spaldrich13/edge-co2-beacon/reports/Presentations/1-Aldrich_Update_Week6 .pdf

## Edge-Based Transportation Classifier for Real-Time CO₂ Estimation

Spencer Aldrich
ECE-499 - Winter 2026
Advisor: Michael Okwori

## Project Recap

- Goal: Classify transportation modes using on-device sensor data
- Target modes: train, subway, car, bus, walk
- Predicted mode feeds directly into CO2
estimation
- Constraints:
- Fully local data processing
- Battery-powered embedded system

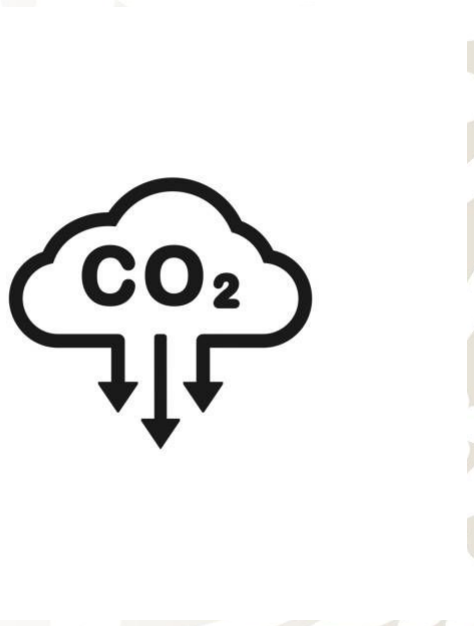
[picture p4: figure]

## Overall System Design

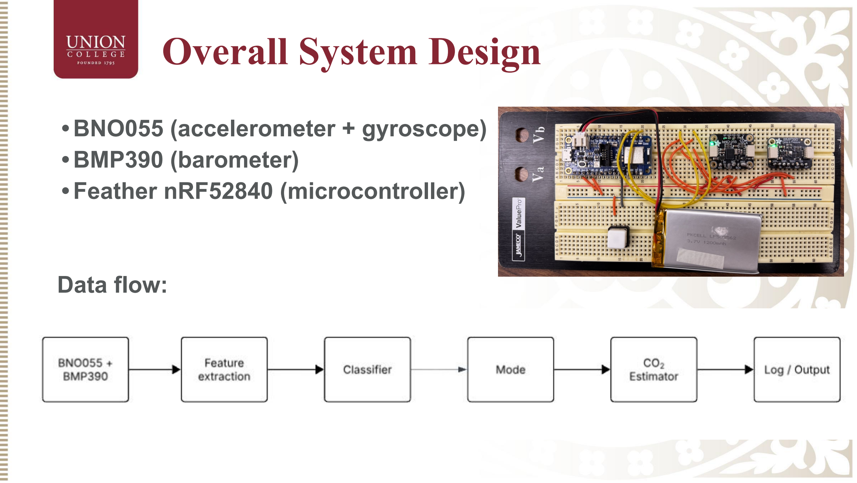
[picture p5: page 3]

- BNO055 (accelerometer + gyroscope)
- BMP390 (barometer)
- Feather nRF52840 (microcontroller)

Data flow:

•

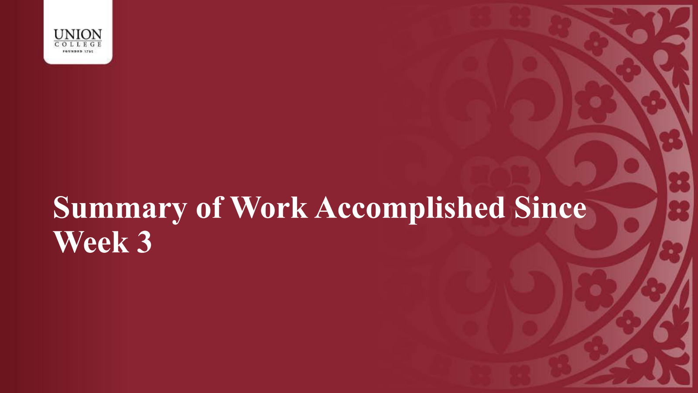
[picture p6: page 4]

## Summary of Work Accomplished Since Week 3

## Summary of Data Collection

•Self-collected dataset only (no SHL yet)
- Total Data Collected:
- Train: 81 minutes (~121,000 samples)
- Subway: 21 minutes (~31,500 samples)
- Car: 42 minutes (~63,000 samples)
- Bus: 58 minutes (~87,000 samples)
- Walk: 16 minutes (~24,000 samples)

## Data Preprocessing & Windowing

•Windowing: 5-second windows @ 25 hz (125 samples/window)
- Channels/windows: ax, ay, az, gx, gy, gz, pressure (7 total)
- Normalization: per-channel z-score using training-set mean/std

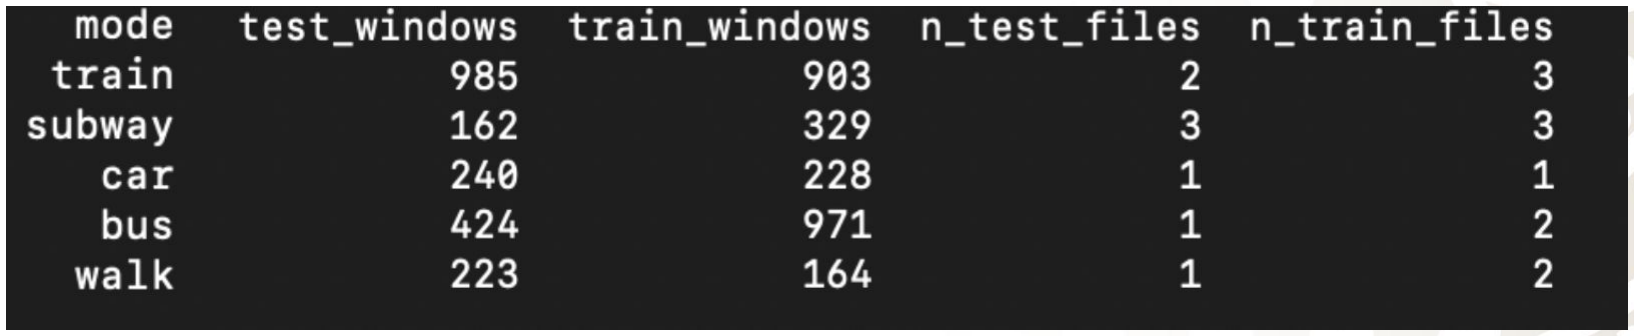
[picture p7: figure]

## Feature Variability Analysis

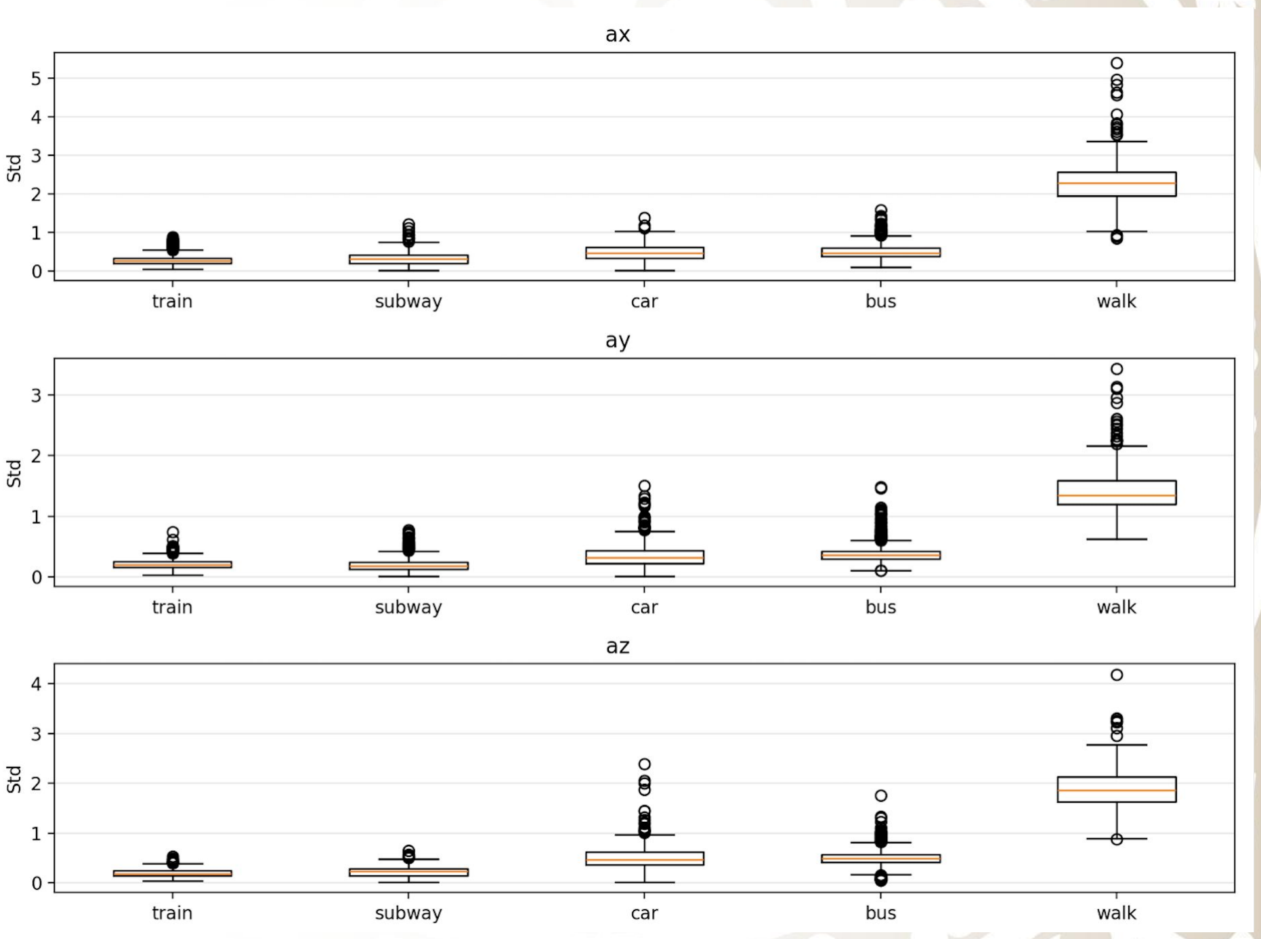
[picture p8: figure]

•Standard deviation computed per 5 second window.
- Captures short-term motion dynamics
- Higher std -> more
vibration/variation in that sensor during the window.

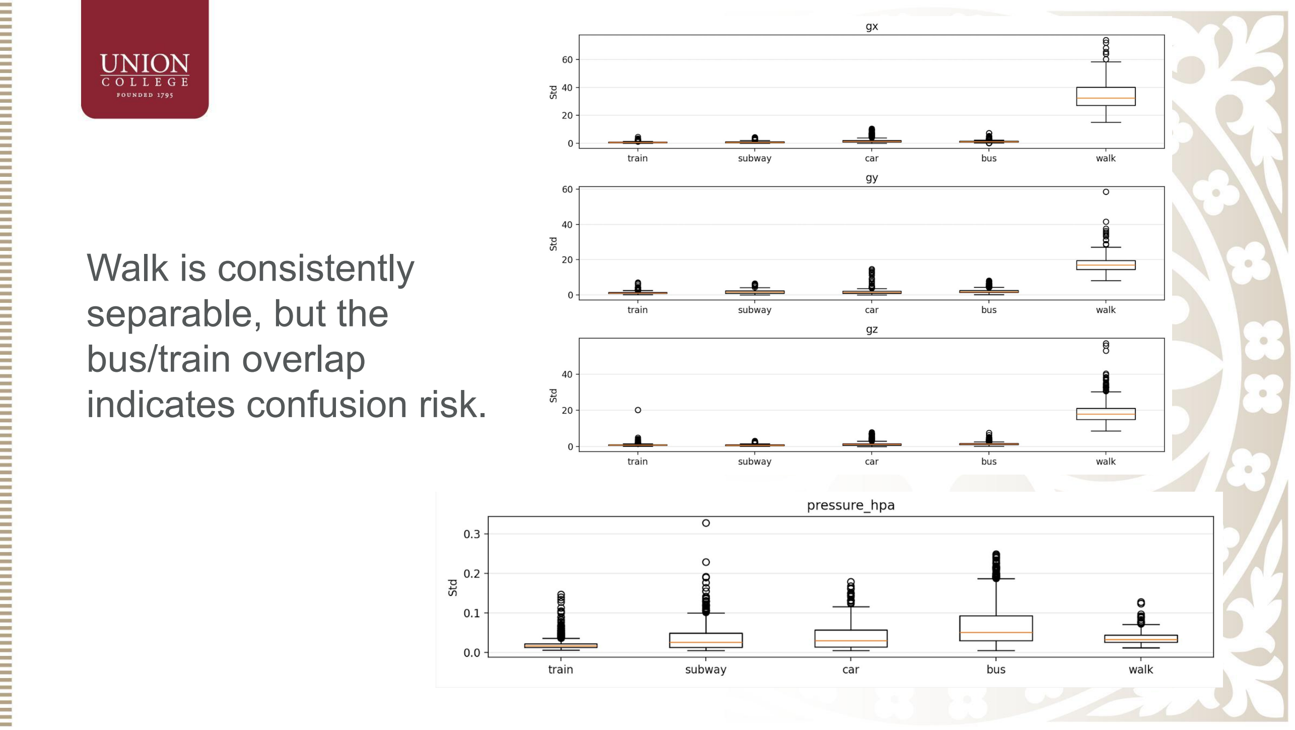
[picture p9: page 8]

Walk is consistently
separable, but the
bus/train overlap
indicates confusion risk.

## Baseline Model Selection

•Input: 5-second window @ 25 Hz (125 samples x 7 channels)
- Model: Convolutional Neural Network
- Learns motion patterns
automatically
- Strong baseline for IMU
time-series in the literature
- Baseline goal: establish a realistic generalization
benchmark before adding SHL pretraining or extra features.

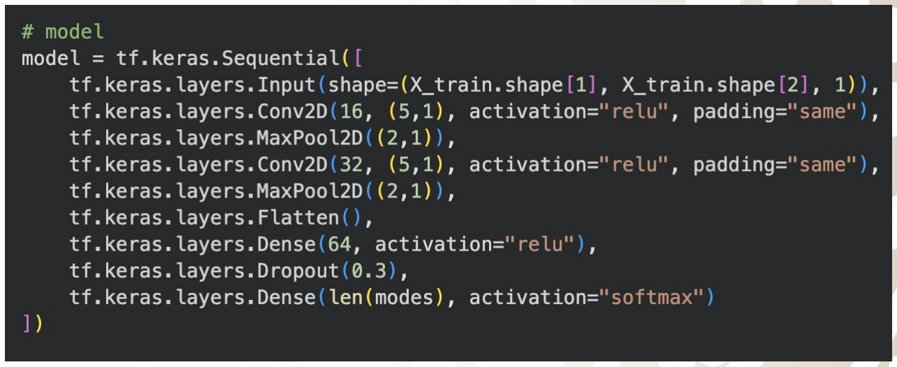
[picture p10: figure]

## Baseline Neural Network (Initial Result)

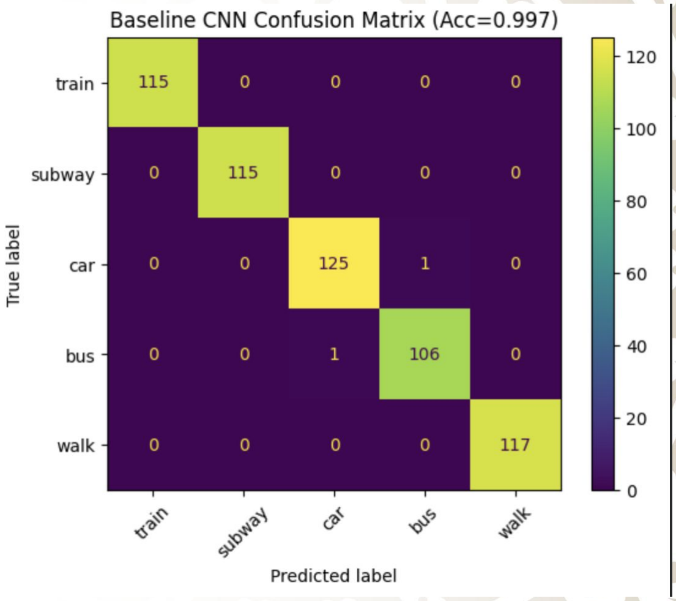
[picture p11: figure]

Initial accuracy: 99.7%
- Window-level random split caused leakage
- Not a valid estimate of
generalization

## Fixing Data Leakage

- Fixed split:
- Entire segments assigned to train or test
- No overlapping windows
across split
- Bus often misclassified with train, car also mixes with train/bus
- Baseline is limited to a small number of unique segments
(bus/car)

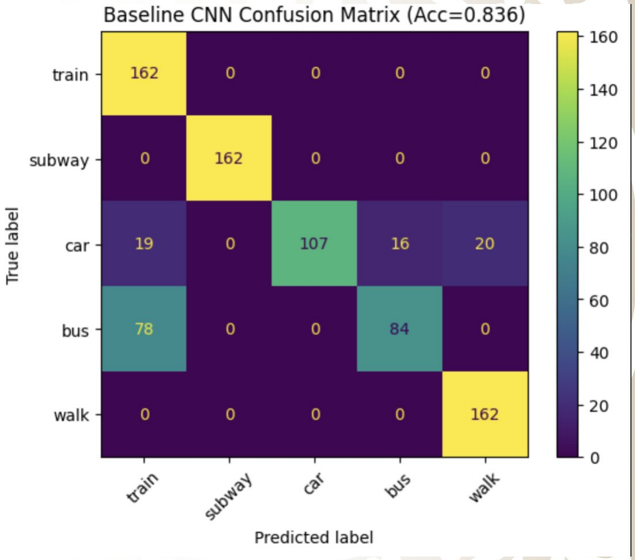
[picture p12: figure]

Classification Accuracy Target: ≥ 90%

## Plan for Remaining Project

Timeframe | Focus | Key Tasks | Outcome
Week 7 | Data and Model Generalization | ● SHL preprocessing and pretraining ● Fine-tune on self-collected data | Improved generalization on self-collected data
Week 8 | Model Refinement | ● Reduce bus/train confusion ● Validate on held-out self segments | Stable confusion matrix
Week 9 | CO2 Estimation | ● Apply emission factors per mode ● Compare predicted vs. true CO2 | CO2 error characterization
Weeks 10-11 | Deployment & Finalization | ● Model compression ● Latency + power evaluation | Final validated system
- Final Presentation
- Final Report

## Thank you

Questions?

aldrichs@union.edu

# Appendix - SHL Dataset (Sussex -Huawei Locomotion)

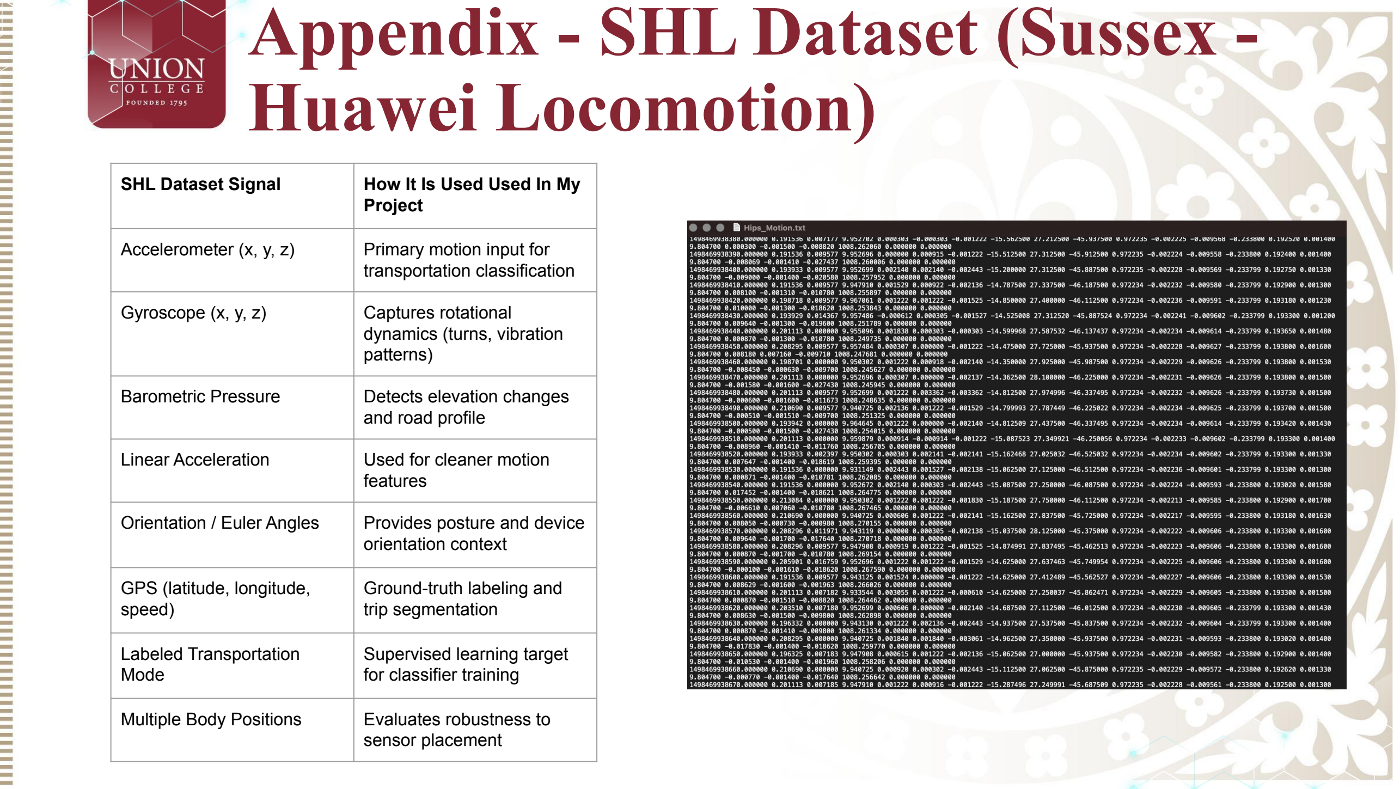
[picture p13: page 14]

SHL Dataset Signal | How It Is Used Used In My Project
Accelerometer (x, y, z) | Primary motion input for transportation classification
Gyroscope (x, y, z) | Captures rotational dynamics (turns, vibration patterns)
Barometric Pressure | Detects elevation changes and road profile
Linear Acceleration | Used for cleaner motion features
Orientation / Euler Angles | Provides posture and device orientation context
GPS (latitude, longitude, speed) | Ground-truth labeling and trip segmentation
Labeled Transportation Mode | Supervised learning target for classifier training
Multiple Body Positions | Evaluates robustness to sensor placement

# Appendix - CO2

# Estimation Model

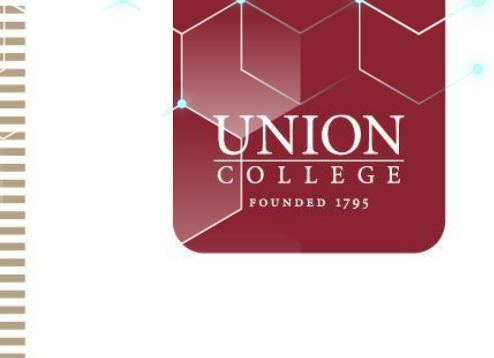
[picture p14: figure]

Objective: Estimate per-trip carbon emissions based on detected transportation mode, duration, and average speed, without continuous GPS tracking.

Calculation Framework:

CO2trip = EFmode * Dest

- EFmode = Emission Factor (grams of CO2

per km)

- Dest = Estimate Distance (km)
- Dest = vavg(mode) * tmode
Mode | Emission Factor (g CO₂ / km)
Car | 170 - 250 g CO₂ / km (per passenger)
Bus | 60 - 110 g CO₂ / km (per passenger)
Train | 25 - 45 g CO₂ / km (per passenger)
Subway | 44 - 65 g CO₂ / km (per passenger)
Walk | 0 g CO₂ / km (per passenger)

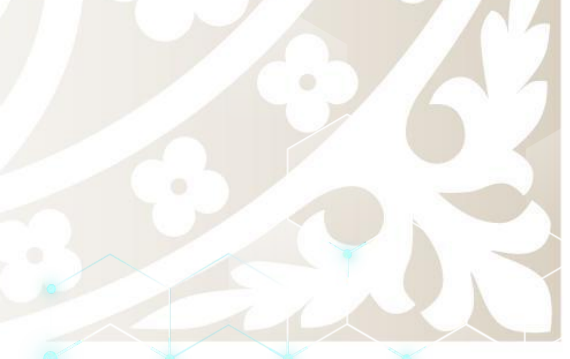
[picture p15: figure]

# Appendix - Acceleration Graphs

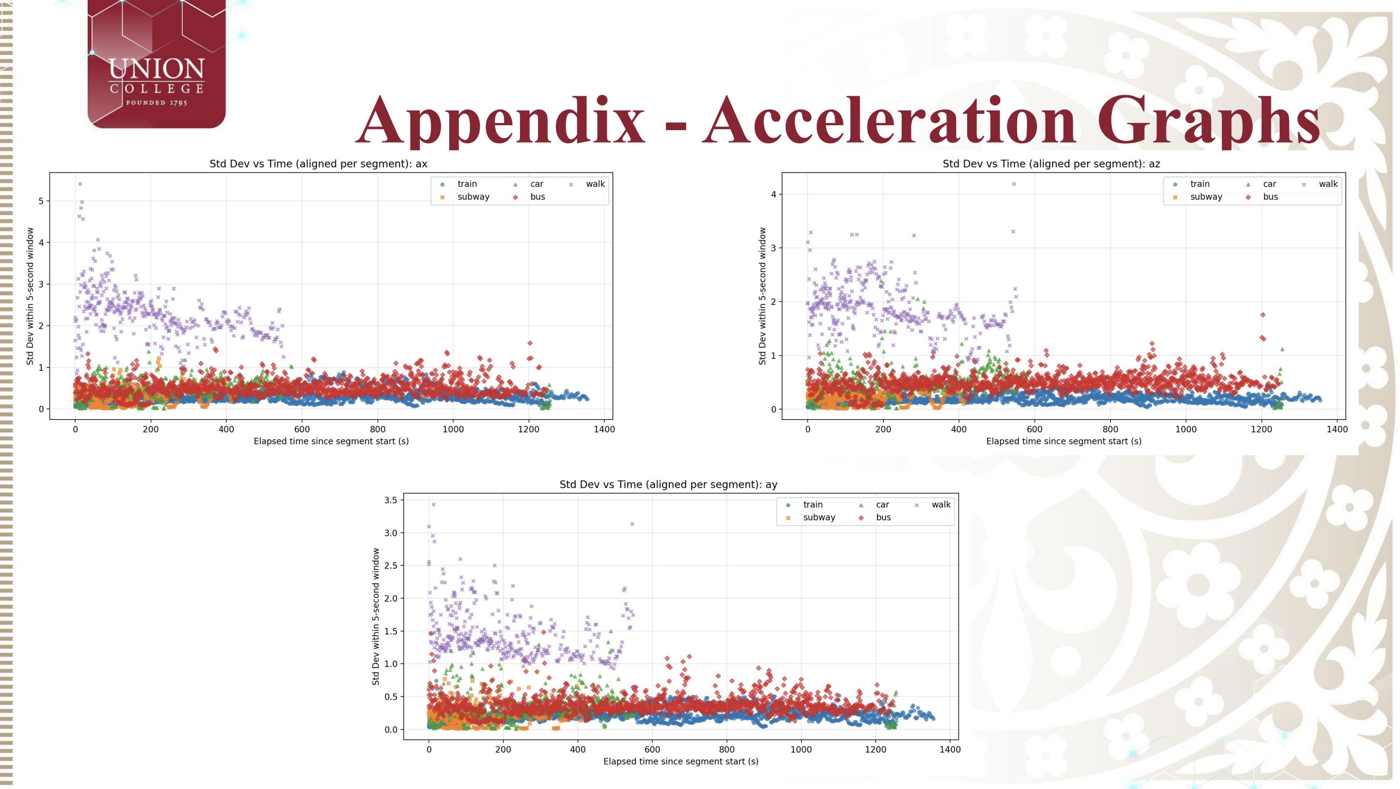
[picture p16: page 16]

# Appendix - Gyroscope Graphs

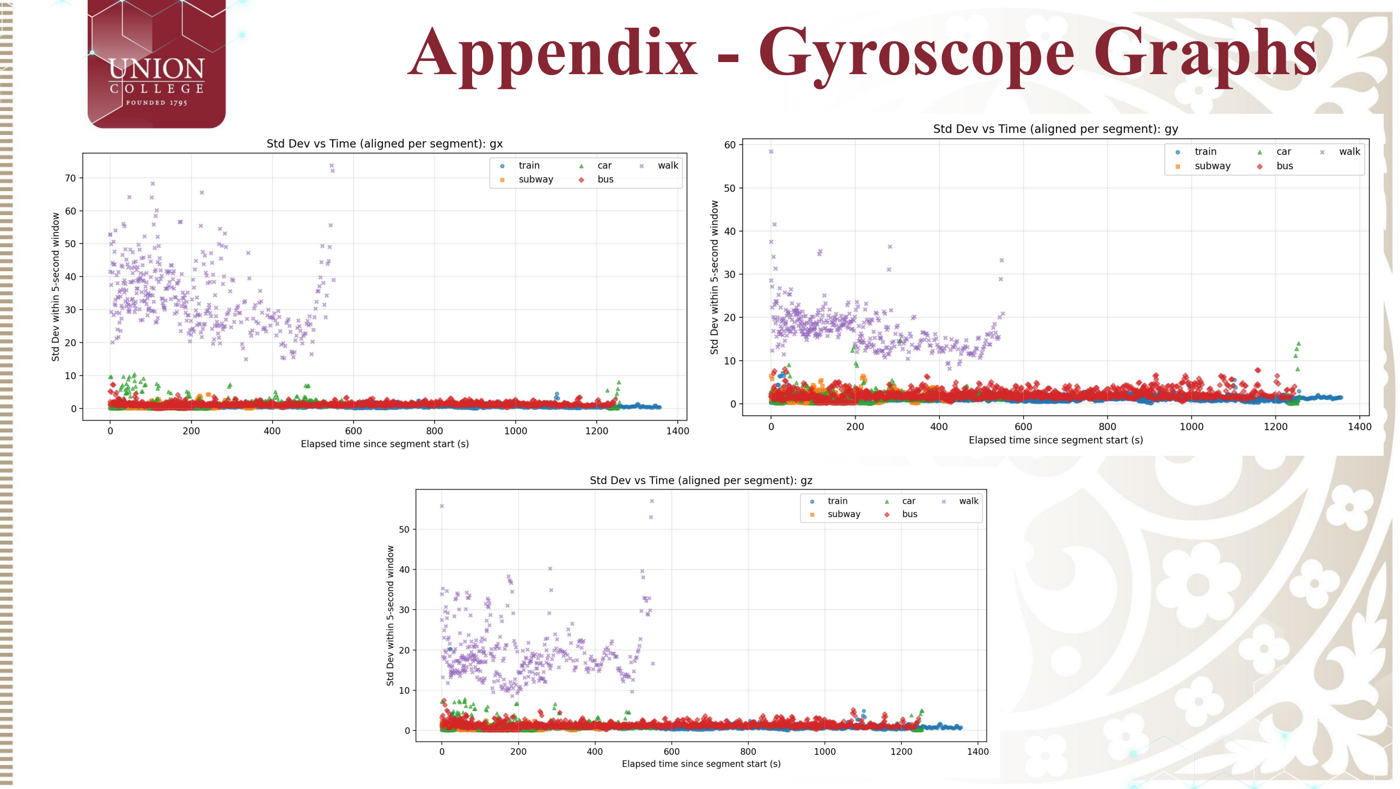
[picture p17: page 17]

# Appendix - Pressure Graph

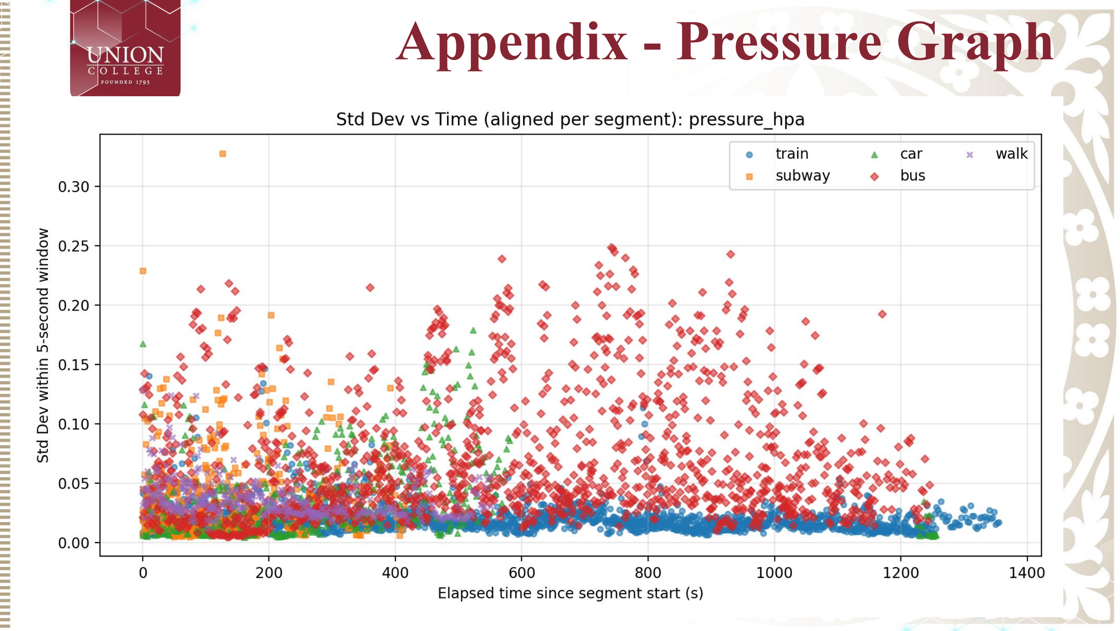
[picture p18: page 18]
