spaldrich13/edge-co2-beacon/logs/EE499 Weekly Activity Sheet_Week4.md

EE499 Weekly Activity Sheet

Name: Spencer Aldrich				Week: 4
Fill 1 before the weekly meeting and 2 after the weekly meeting
What did you work on and achieve this week?
Implemented a push button into the design for starting and stopping a trip. 
Began collecting data, including: 
6 subway segments totaling approximately 30 minutes of data
5 train segments totaling approximately 80 minutes of data

What are you working on/goal for next week?

Complete all remaining transportation mode data collection:
Car, walk, bus
Ensure that coverage across modes is balanced
Organize the dataset into a common training format
