spaldrich13/edge-co2-beacon/figures/ax_corr_std_vs_time.png

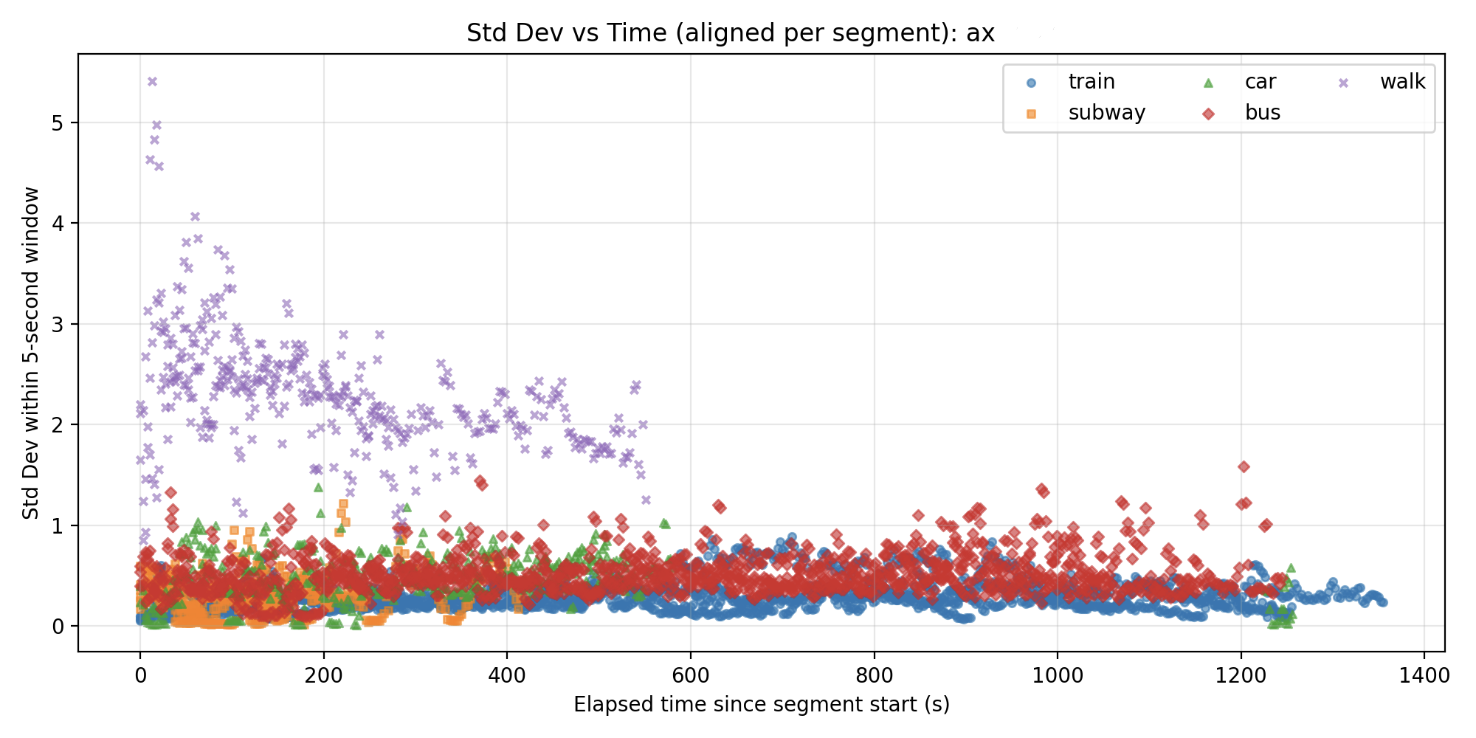
figures/ax_corr_std_vs_time.png
