spaldrich13/edge-co2-beacon/figures/ay_corr_std_vs_time.png

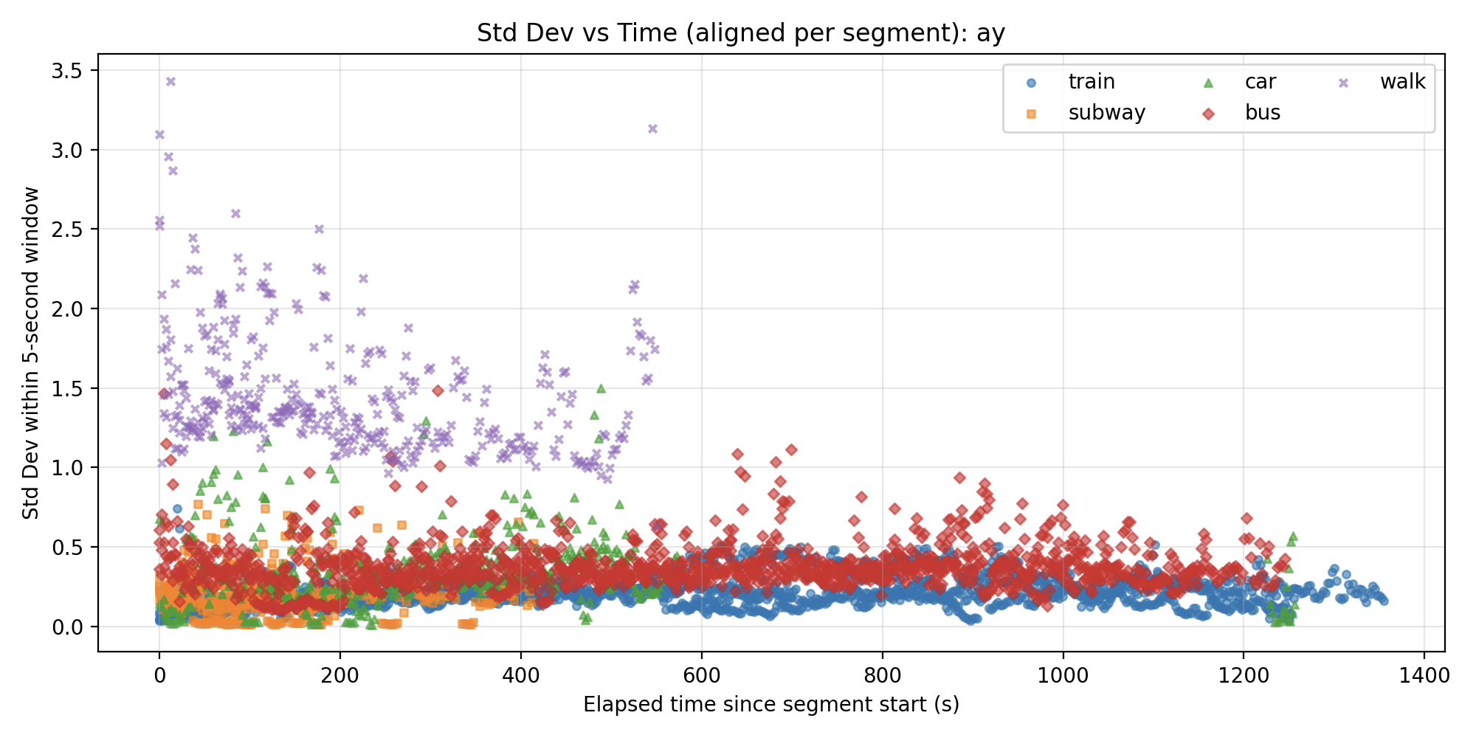
figures/ay_corr_std_vs_time.png
