spaldrich13/edge-co2-beacon/figures/az_corr_std_vs_time.png

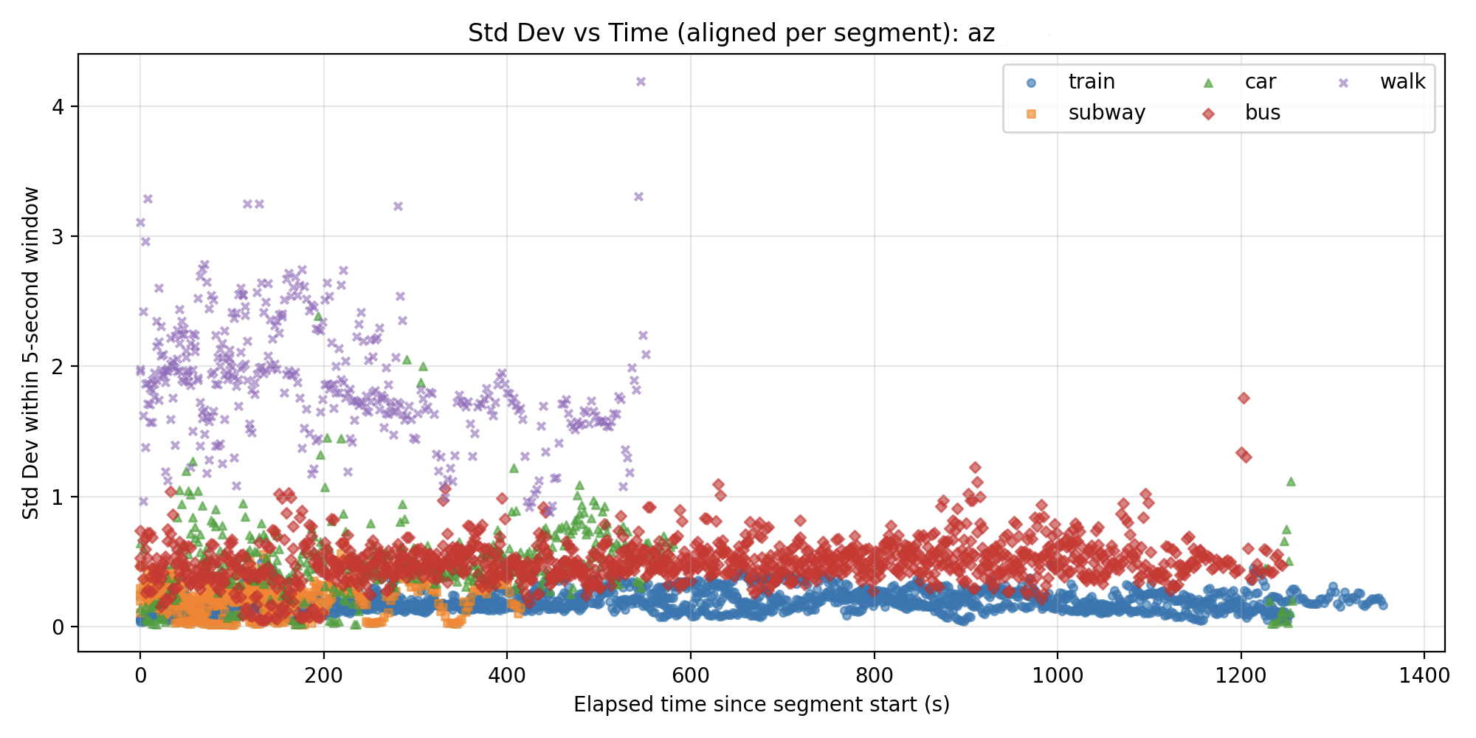
figures/az_corr_std_vs_time.png
