spaldrich13/edge-co2-beacon/figures/confusion matrices/Baseline Confusion Matrix 2:8.png

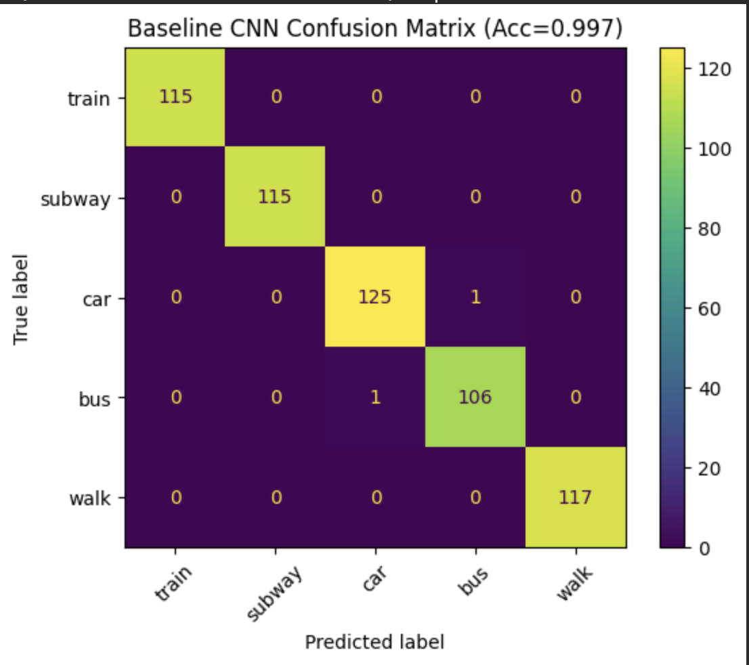
figures/confusion matrices/Baseline Confusion Matrix 2:8.png
