spaldrich13/edge-co2-beacon/figures/figures_boxplots/all_features_std_boxplots.png

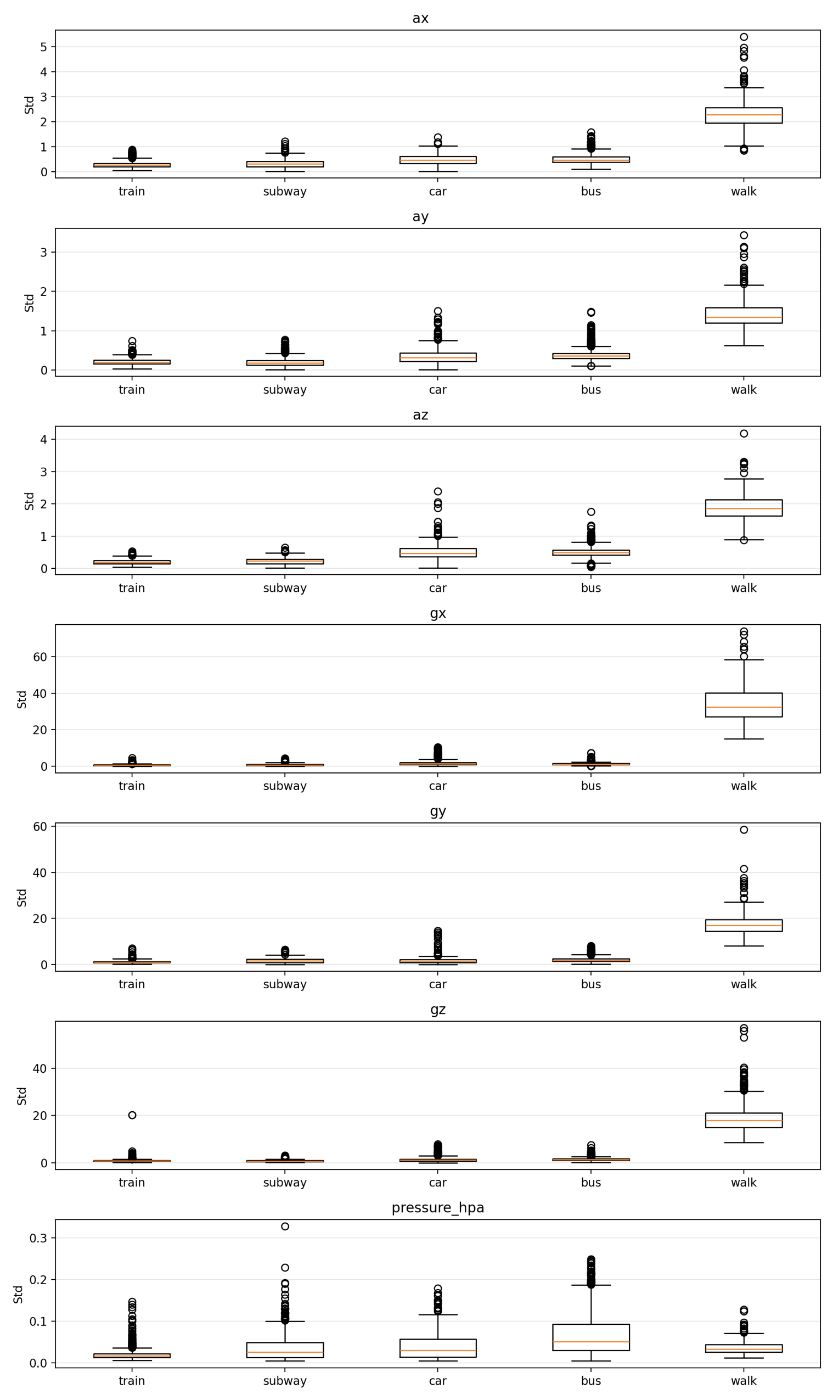
figures/figures_boxplots/all_features_std_boxplots.png
