spaldrich13/edge-co2-beacon/figures/figures_boxplots/az_corr_std_boxplot.png

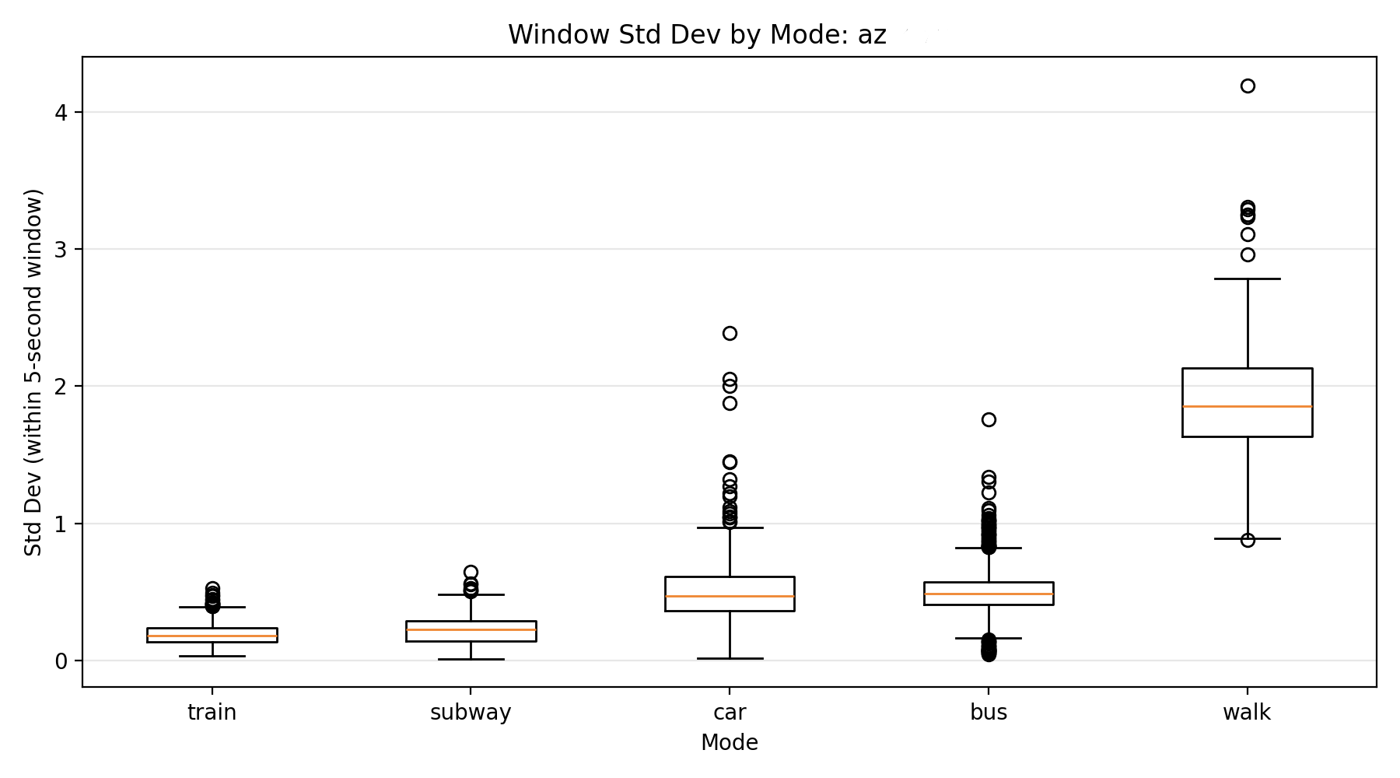
figures/figures_boxplots/az_corr_std_boxplot.png
