spaldrich13/edge-co2-beacon/figures/figures_boxplots/gz_std_boxplot.png

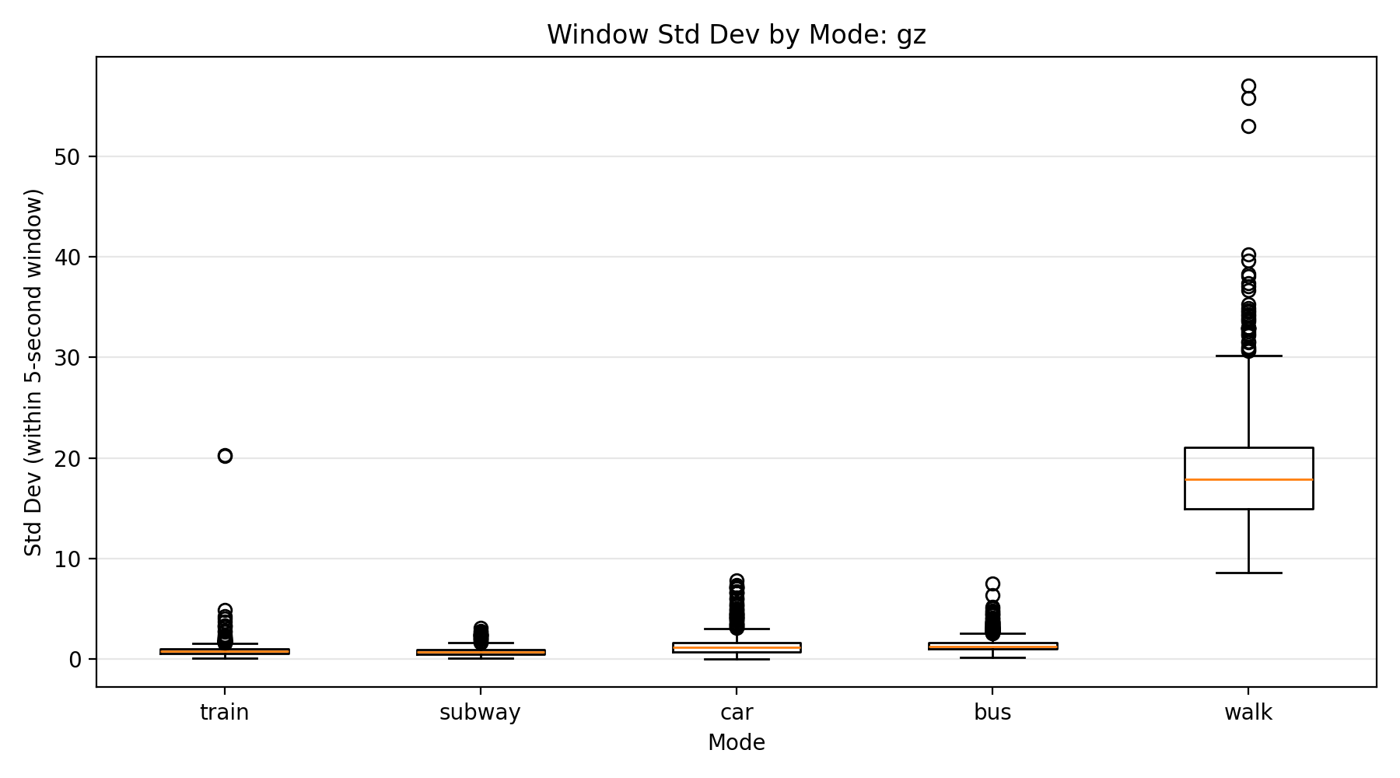
figures/figures_boxplots/gz_std_boxplot.png
