spaldrich13/edge-co2-beacon/figures/figures_boxplots/pressure_hpa_std_boxplot.png

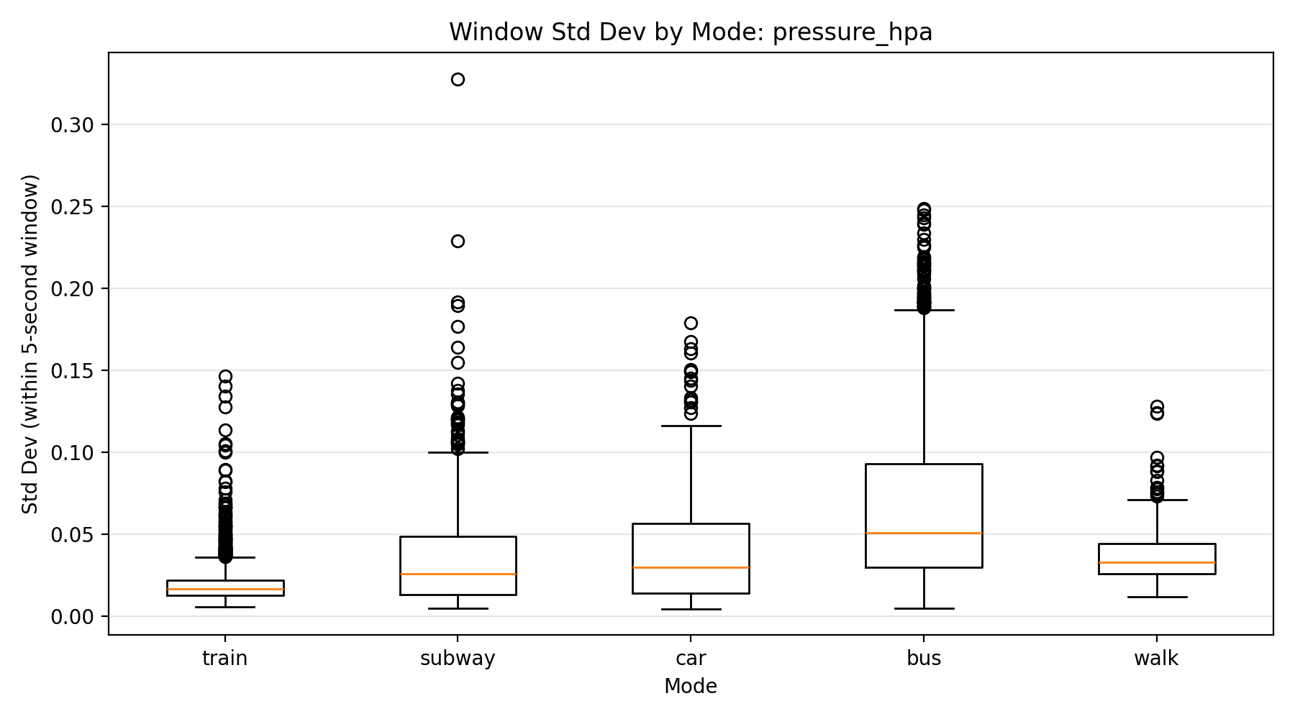
figures/figures_boxplots/pressure_hpa_std_boxplot.png
