spaldrich13/edge-co2-beacon/figures/figures_raw_signals/bus_ay_corr_raw.png

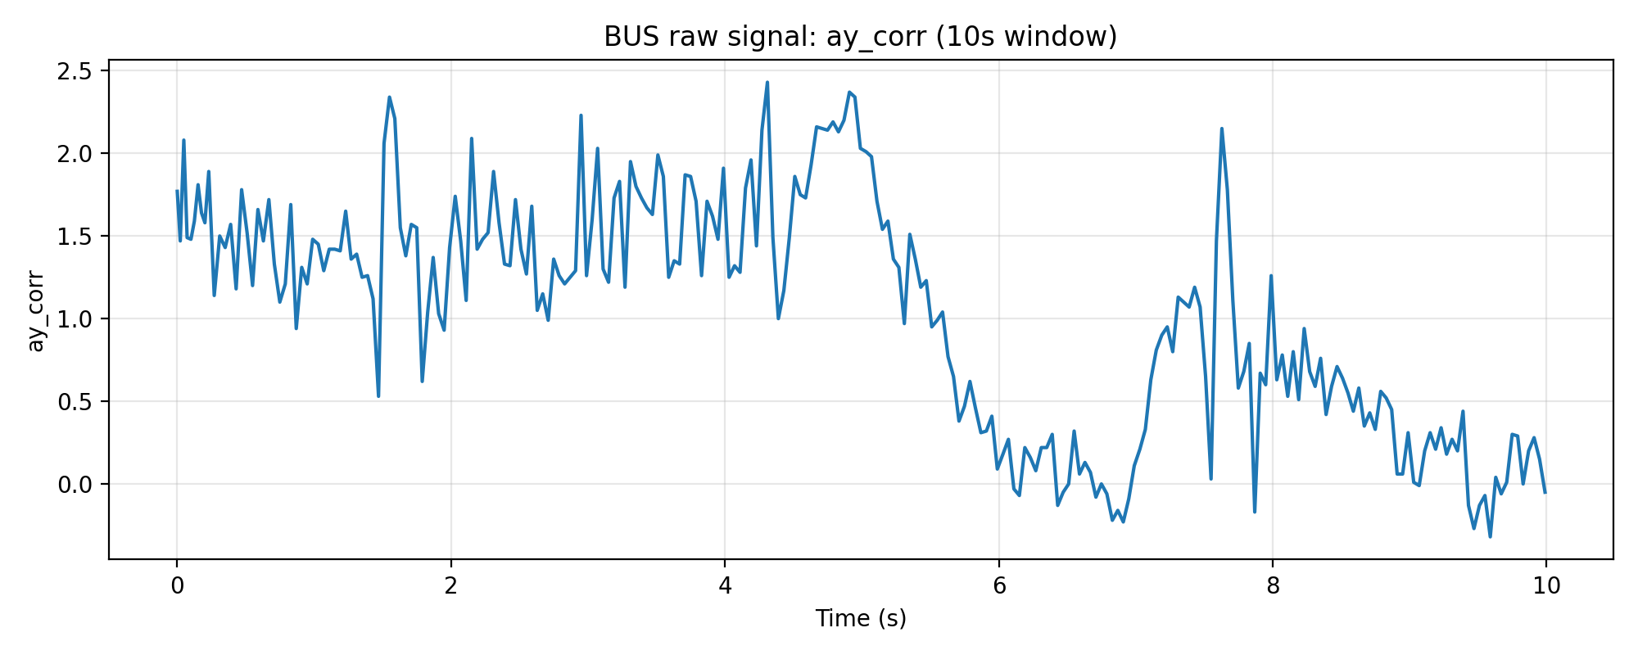
figures/figures_raw_signals/bus_ay_corr_raw.png
