spaldrich13/edge-co2-beacon/figures/figures_raw_signals/bus_pressure_hpa_raw.png

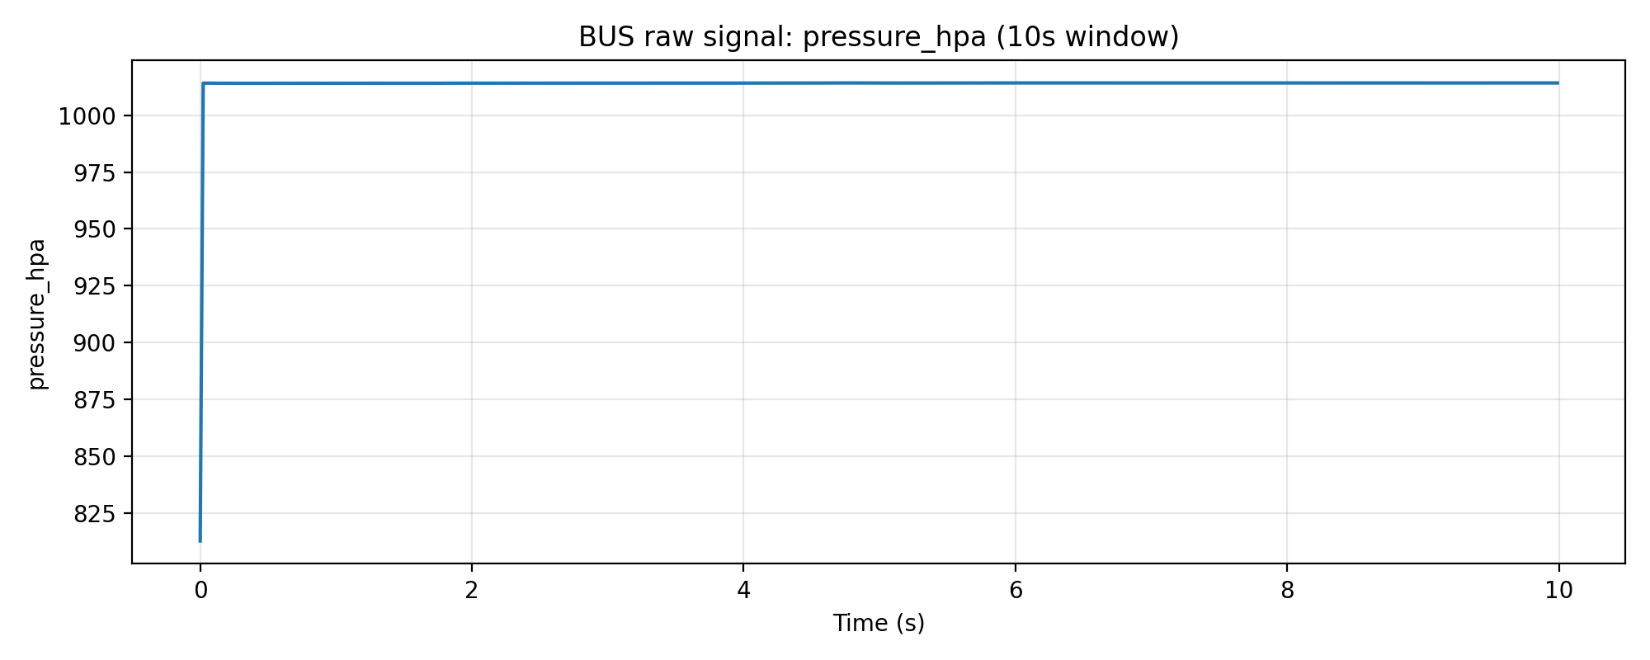
figures/figures_raw_signals/bus_pressure_hpa_raw.png
