spaldrich13/edge-co2-beacon/figures/figures_raw_signals/car_az_corr_raw.png

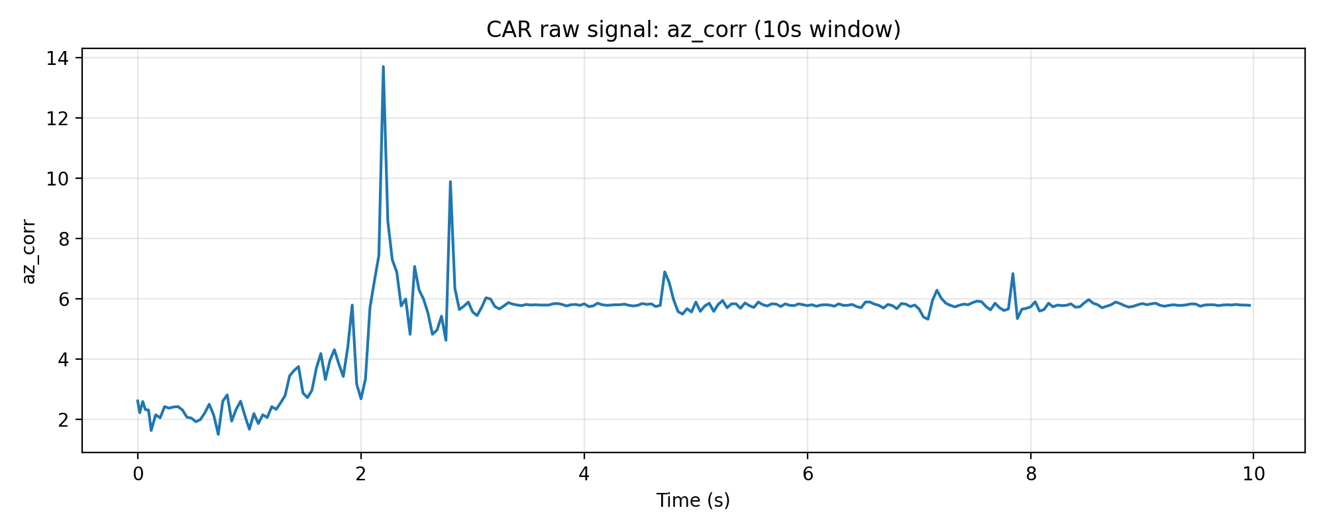
figures/figures_raw_signals/car_az_corr_raw.png
