spaldrich13/edge-co2-beacon/figures/figures_raw_signals/walk_gx_raw.png

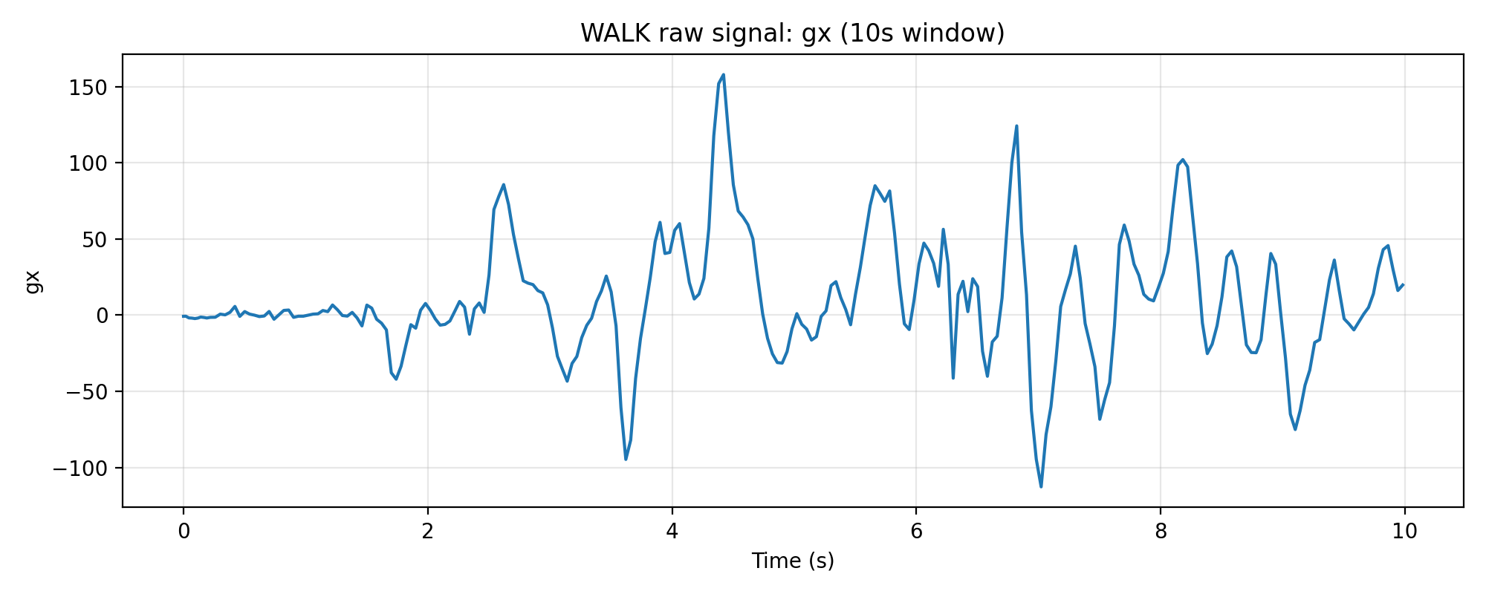
figures/figures_raw_signals/walk_gx_raw.png
