spaldrich13/edge-co2-beacon/figures/figures_raw_signals/walk_gz_raw.png

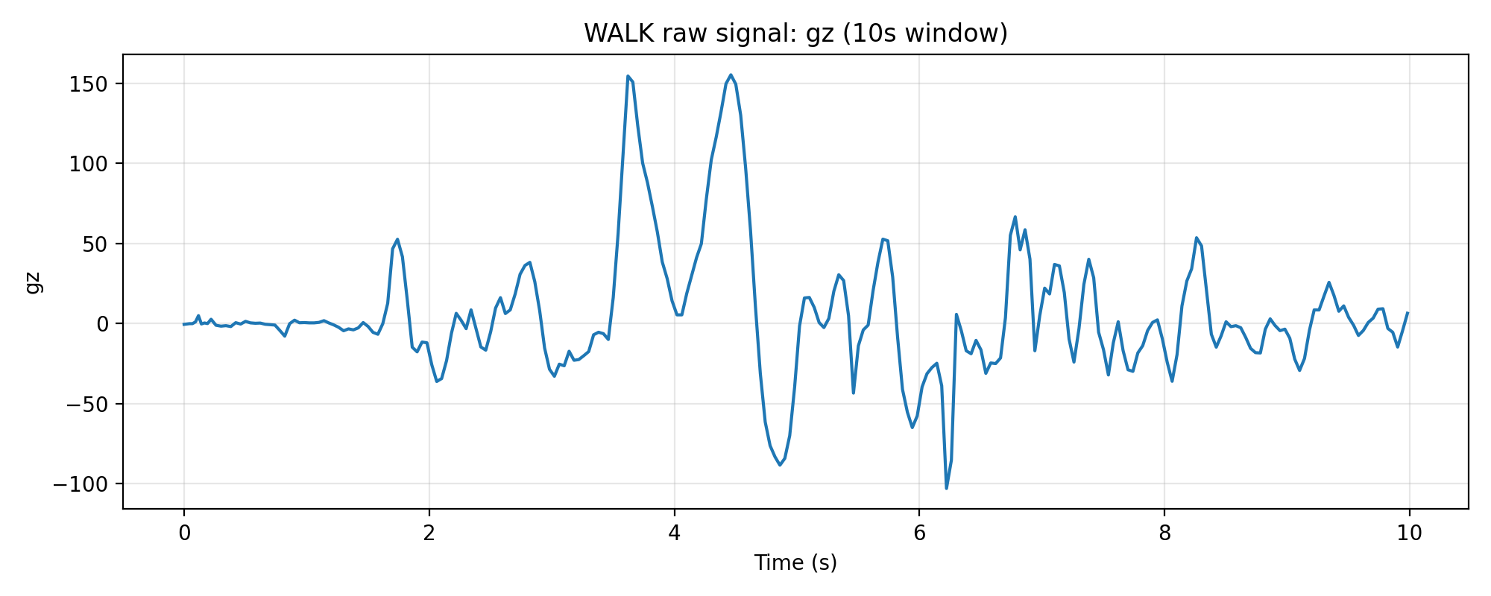
figures/figures_raw_signals/walk_gz_raw.png
