spaldrich13/edge-co2-beacon/figures/gx_std_vs_time.png

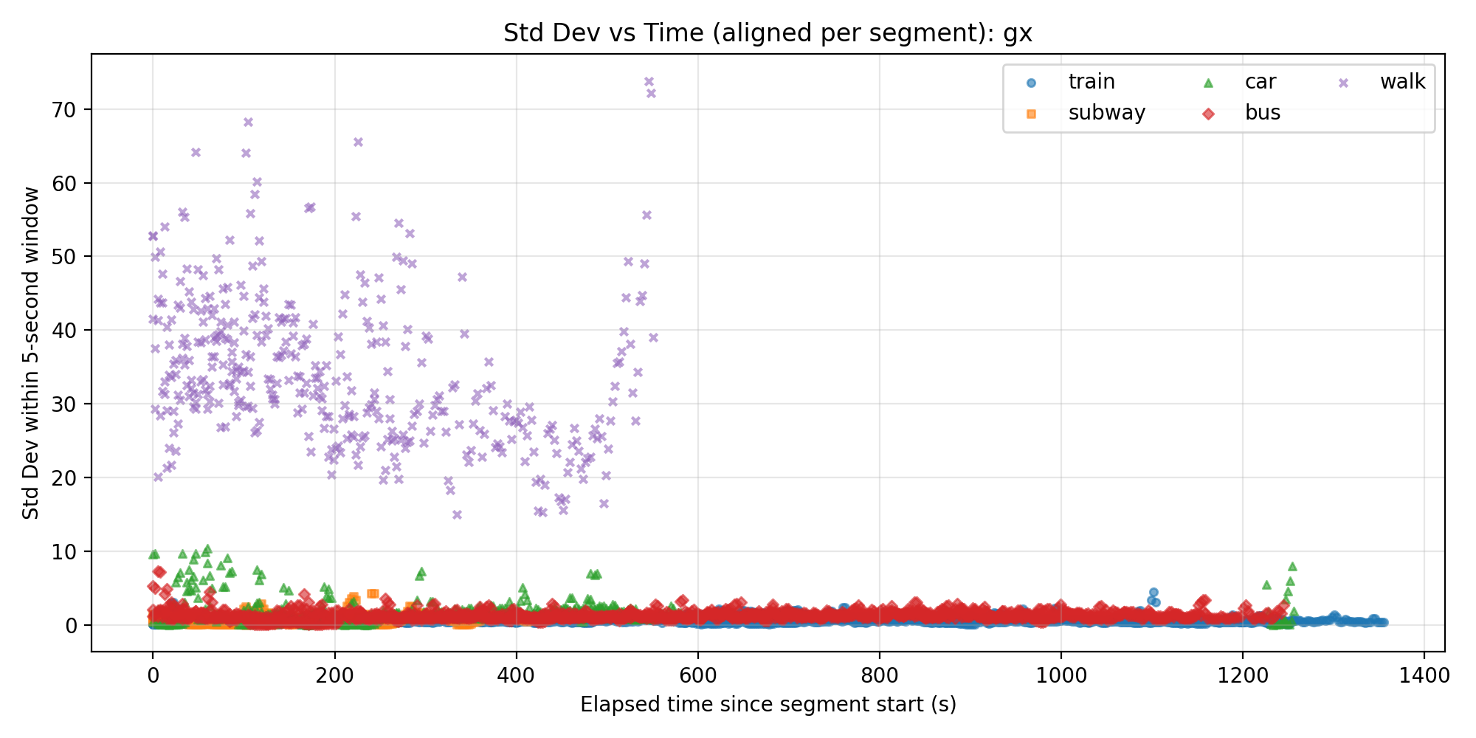
figures/gx_std_vs_time.png
