spaldrich13/edge-co2-beacon/figures/gy_std_vs_time.png

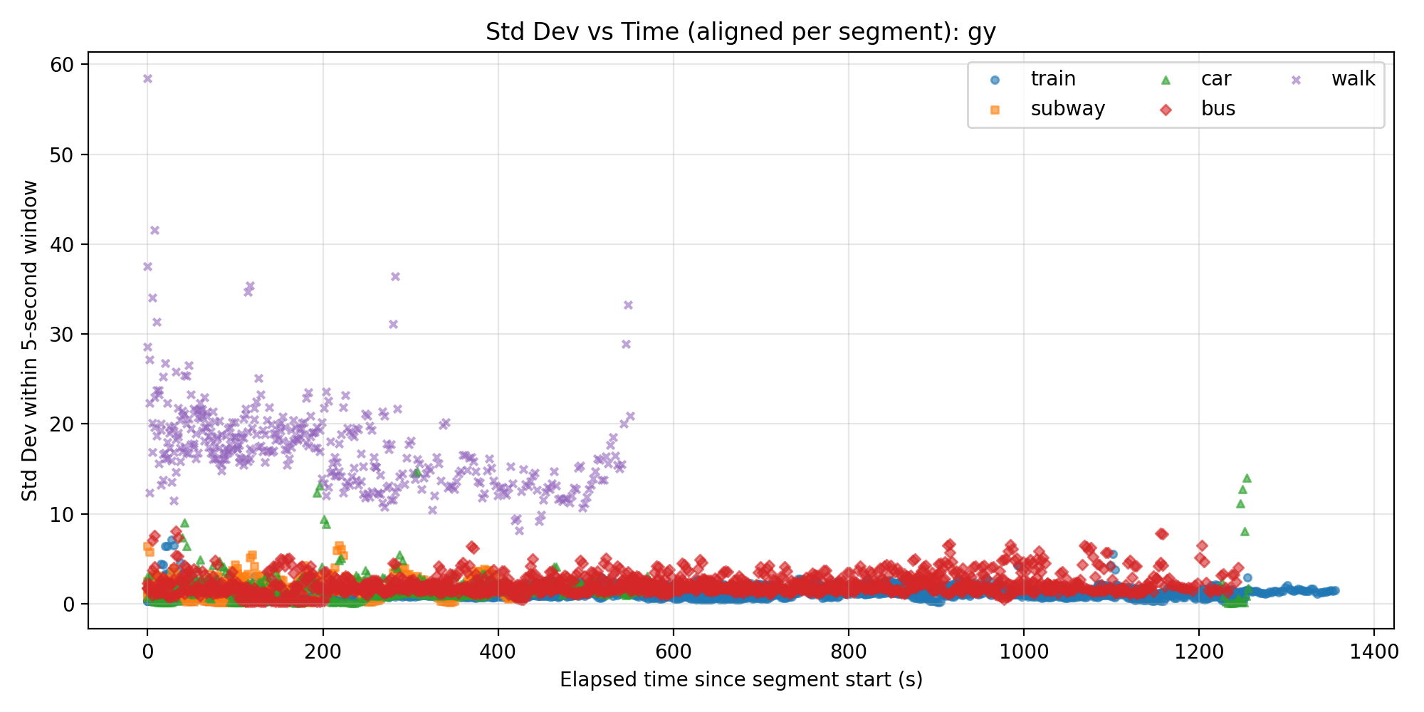
figures/gy_std_vs_time.png
