spaldrich13/edge-co2-beacon/figures/gyro_std_boxplots.png

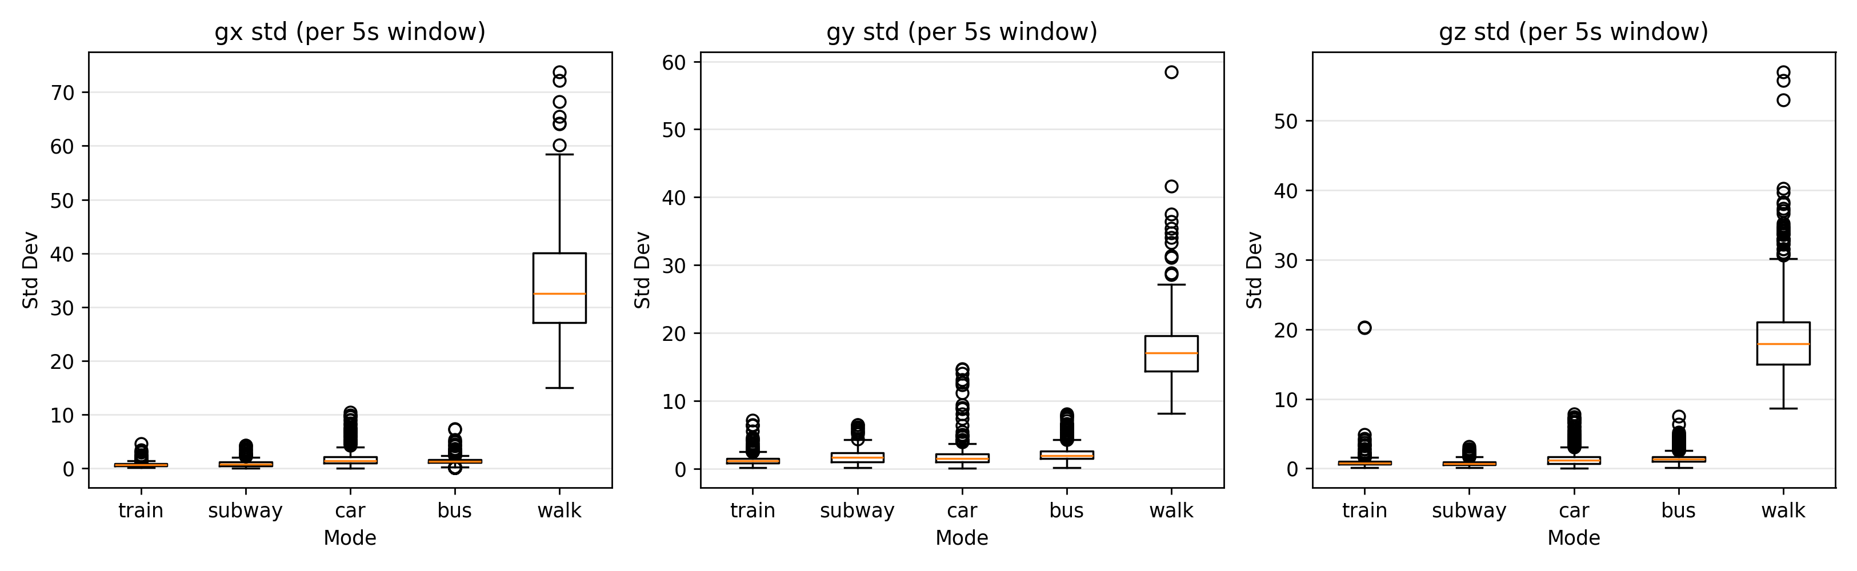
figures/gyro_std_boxplots.png
