spaldrich13/edge-co2-beacon/figures/gyro_std_mean_boxplot.png

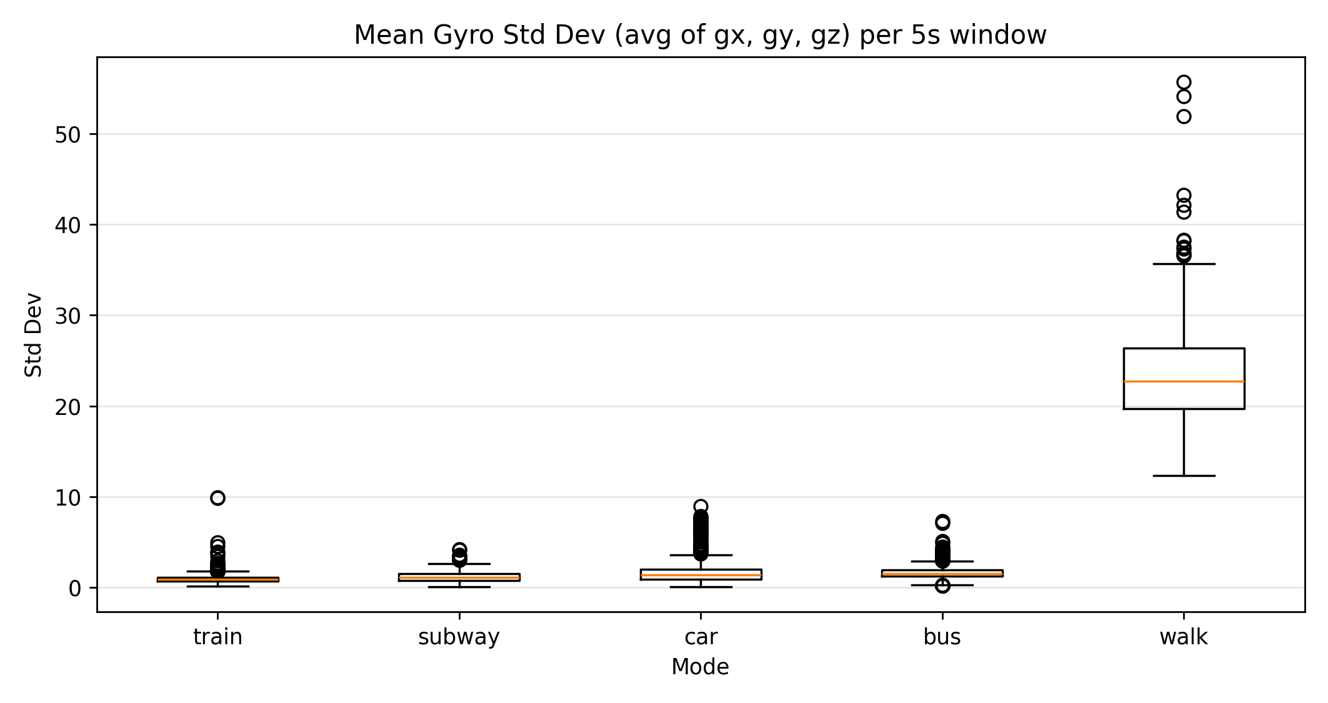
figures/gyro_std_mean_boxplot.png
