spaldrich13/edge-co2-beacon/figures/gz_std_vs_time.png

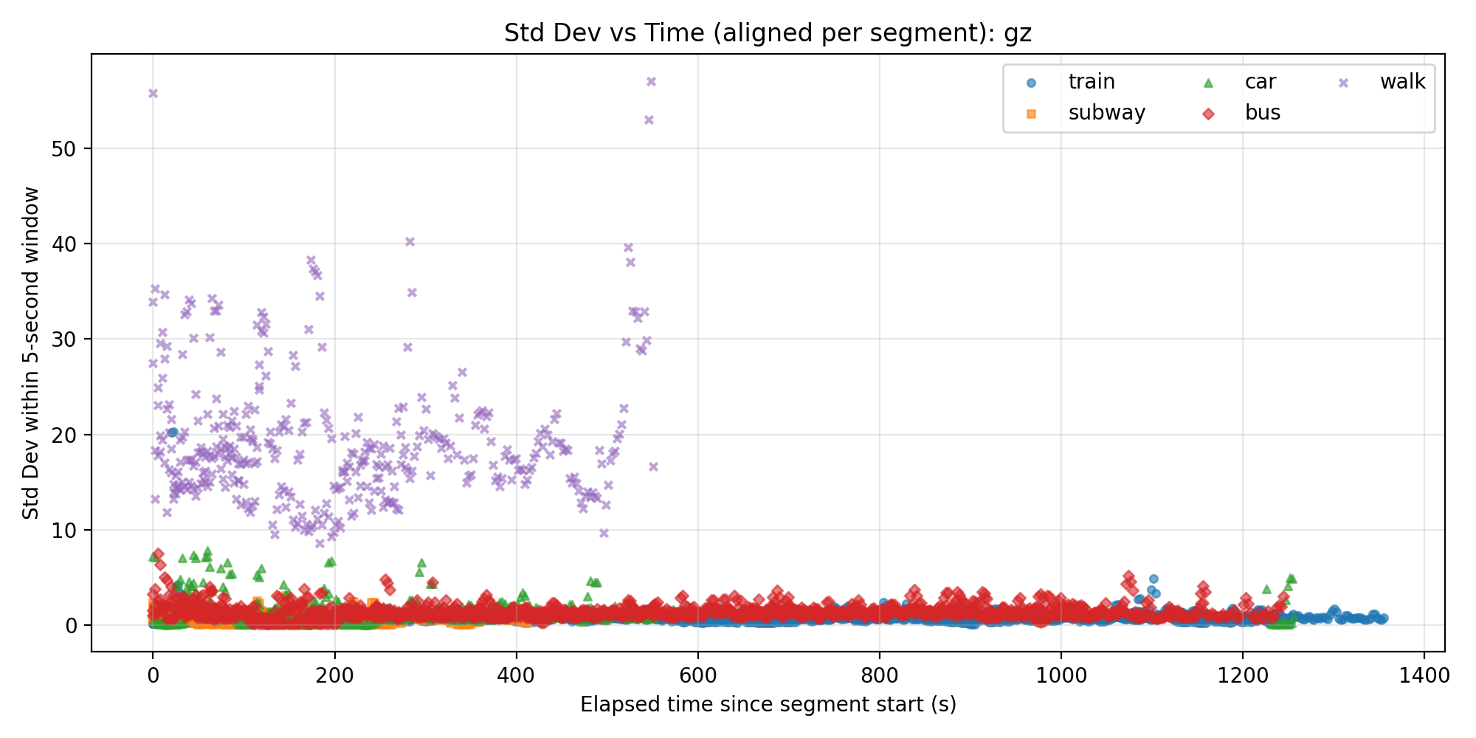
figures/gz_std_vs_time.png
