spaldrich13/edge-co2-beacon/figures/pressure_hpa_std_vs_time.png

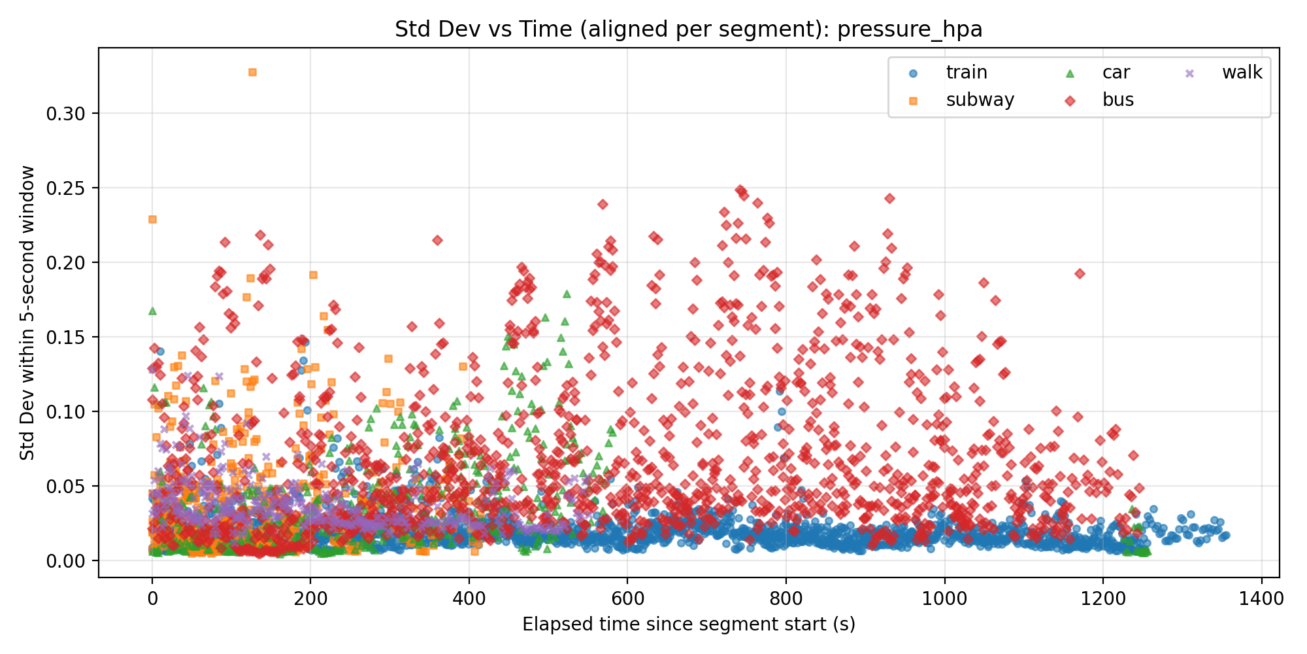
figures/pressure_hpa_std_vs_time.png
