spaldrich13/edge-co2-beacon/figures/std_vs_time_all_features.png

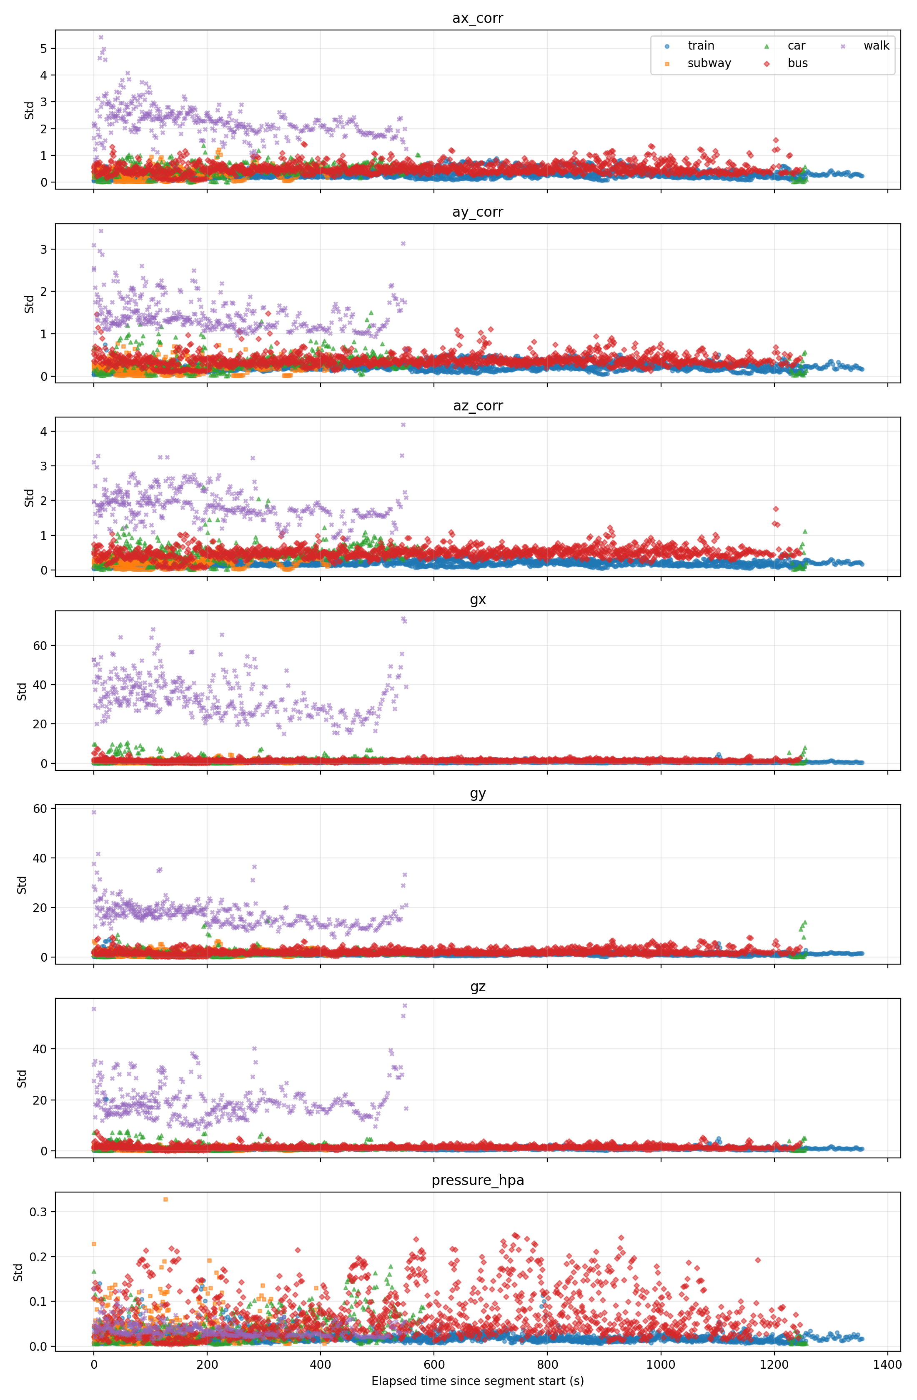
figures/std_vs_time_all_features.png
