spaldrich13/edge-co2-beacon/figures/Updated Prototype .png

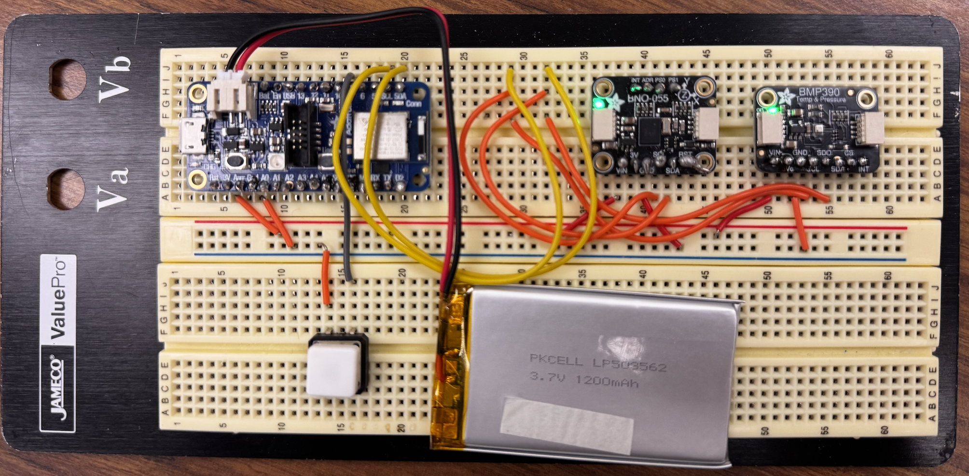
figures/Updated Prototype .png
