spaldrich13/edge-co2-beacon/notebooks/figs_fft/fft_ax_corr.png

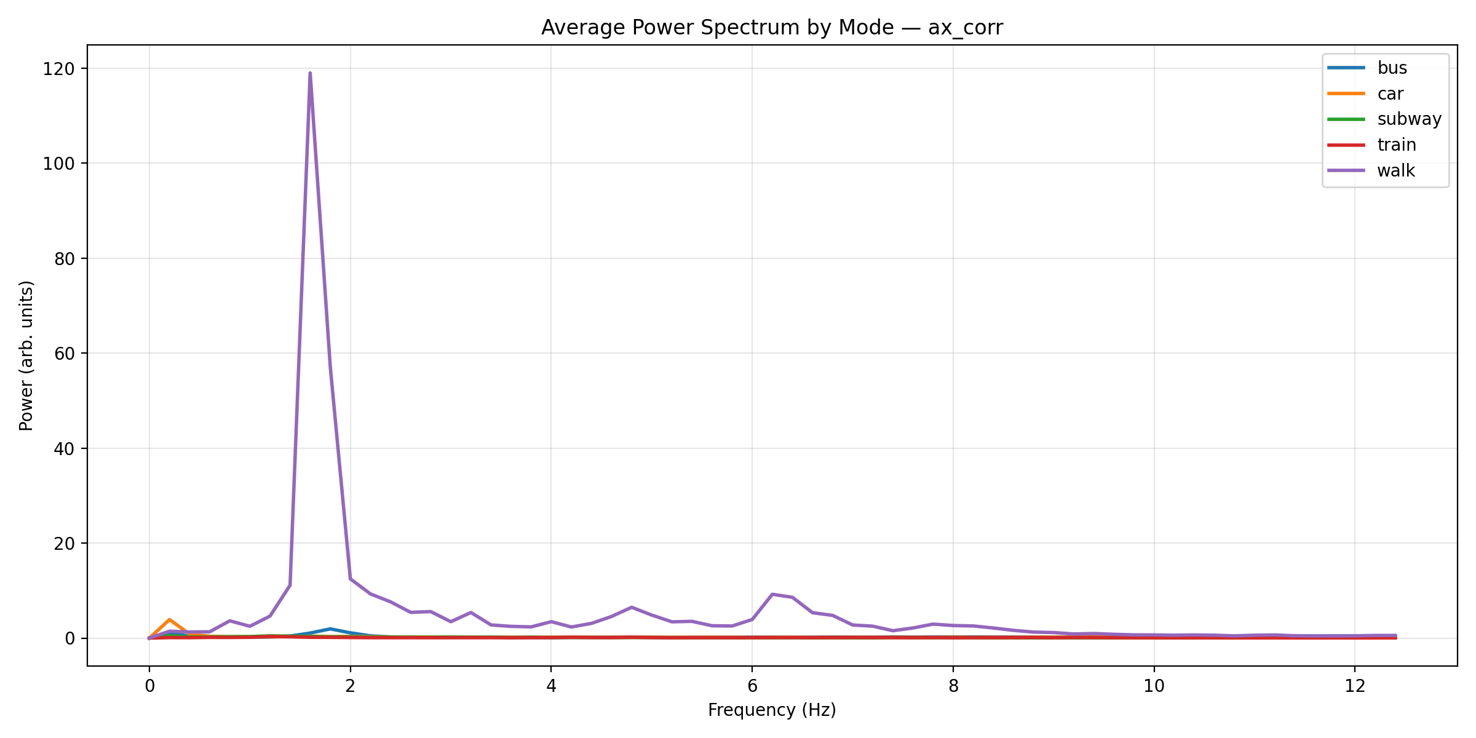
notebooks/figs_fft/fft_ax_corr.png
