spaldrich13/edge-co2-beacon/notebooks/figs_fft/fft_ay_corr.png

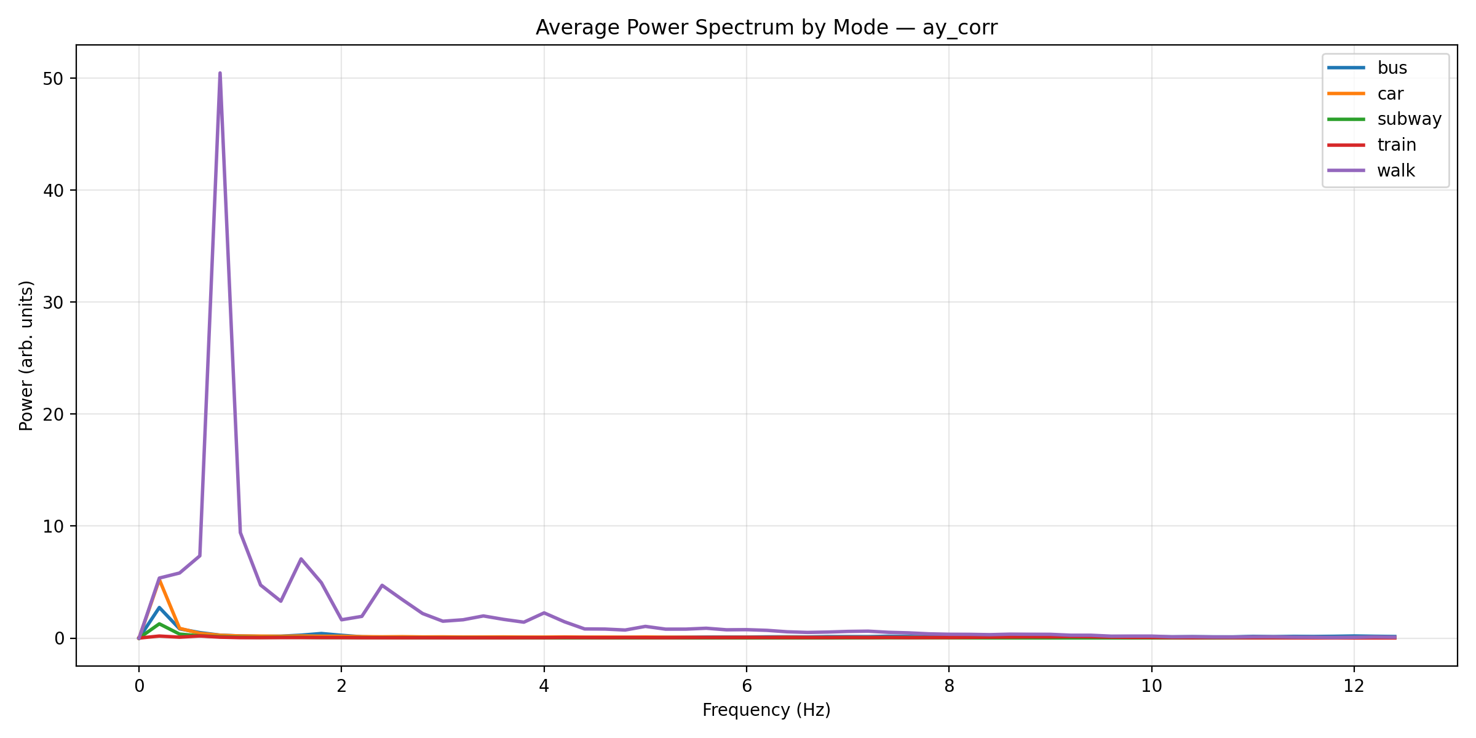
notebooks/figs_fft/fft_ay_corr.png
