spaldrich13/edge-co2-beacon/notebooks/figs_fft/fft_gx.png

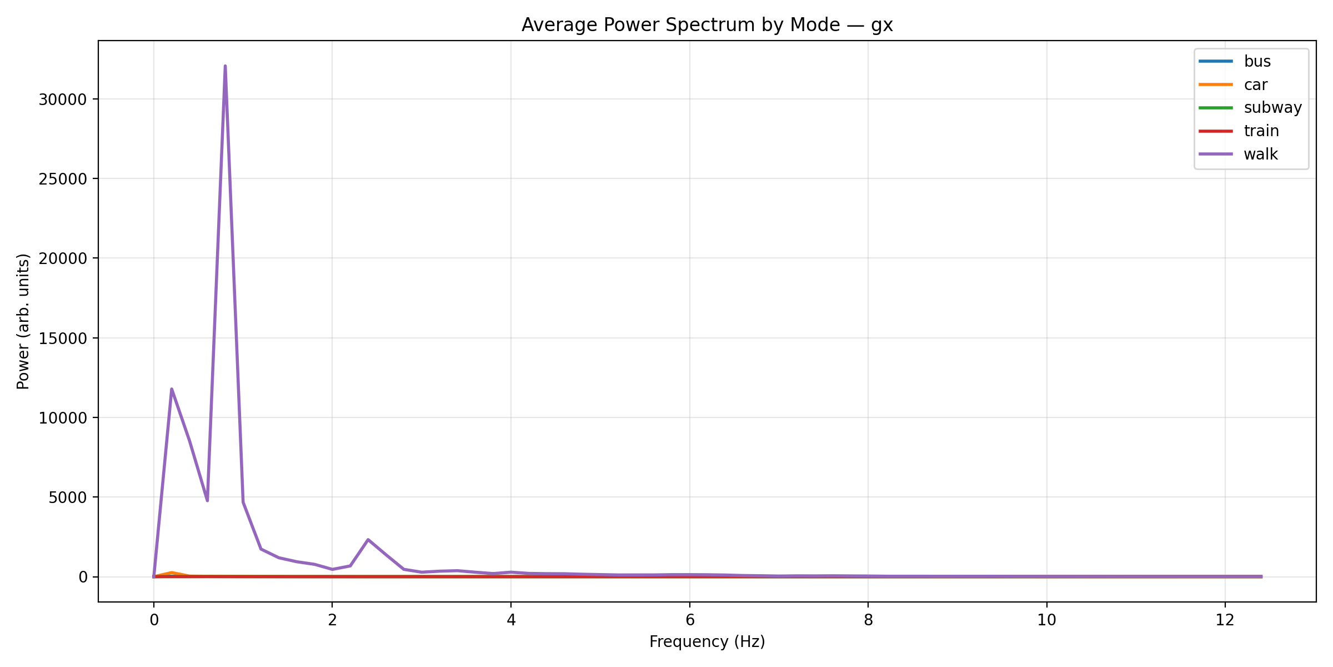
notebooks/figs_fft/fft_gx.png
