spaldrich13/edge-co2-beacon/notebooks/figs_fft/fft_pressure_hpa.png

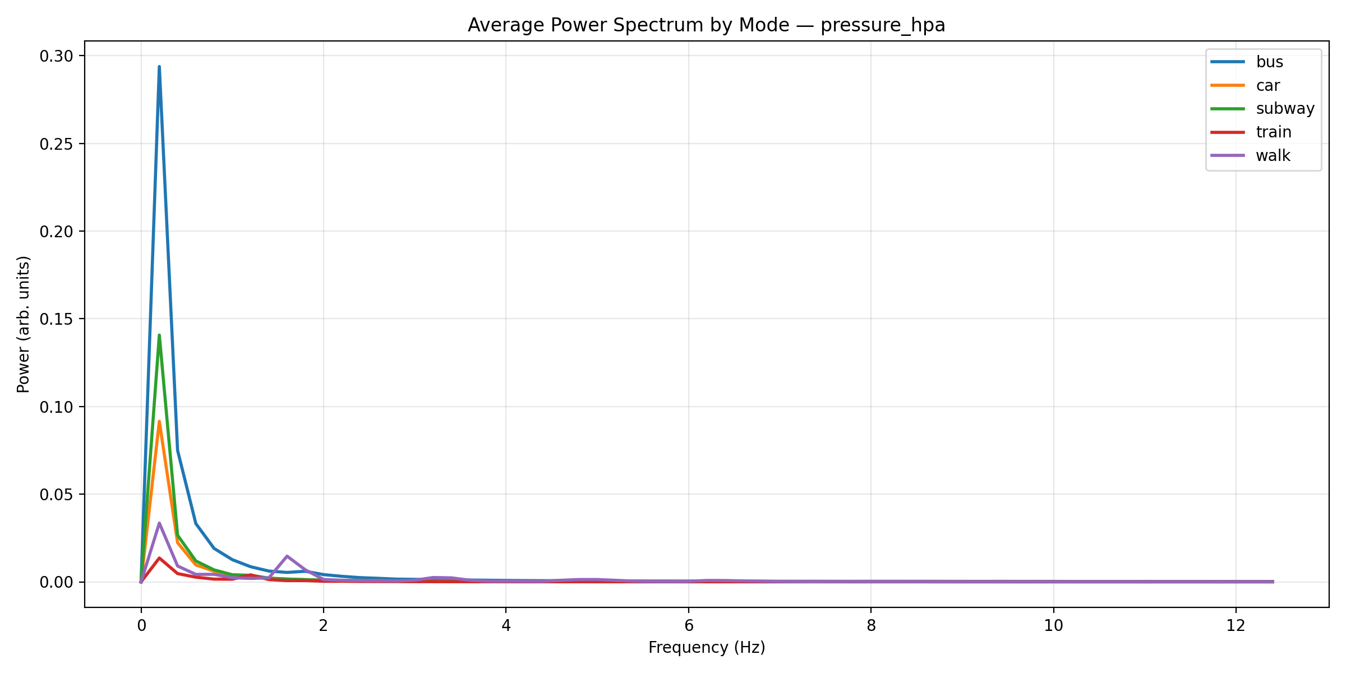
notebooks/figs_fft/fft_pressure_hpa.png
