spaldrich13/edge-co2-beacon/notebooks/figs_pca/pca_2d_projection.png

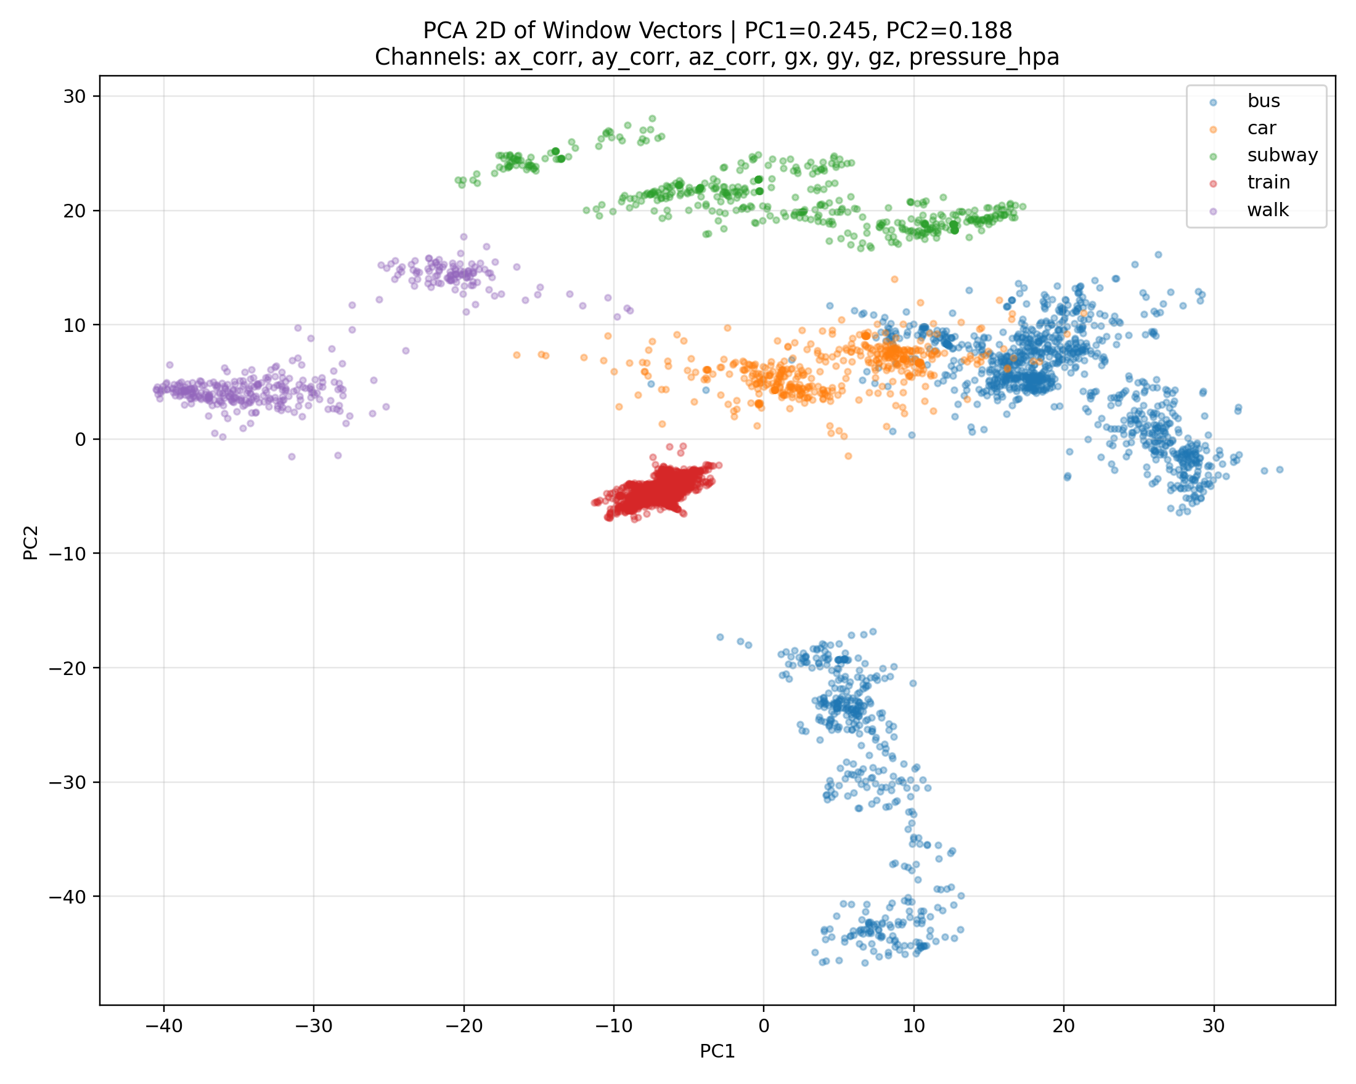
notebooks/figs_pca/pca_2d_projection.png
