spaldrich13/edge-co2-beacon/notebooks/plots_waveforms/overlay_bus_gx.png

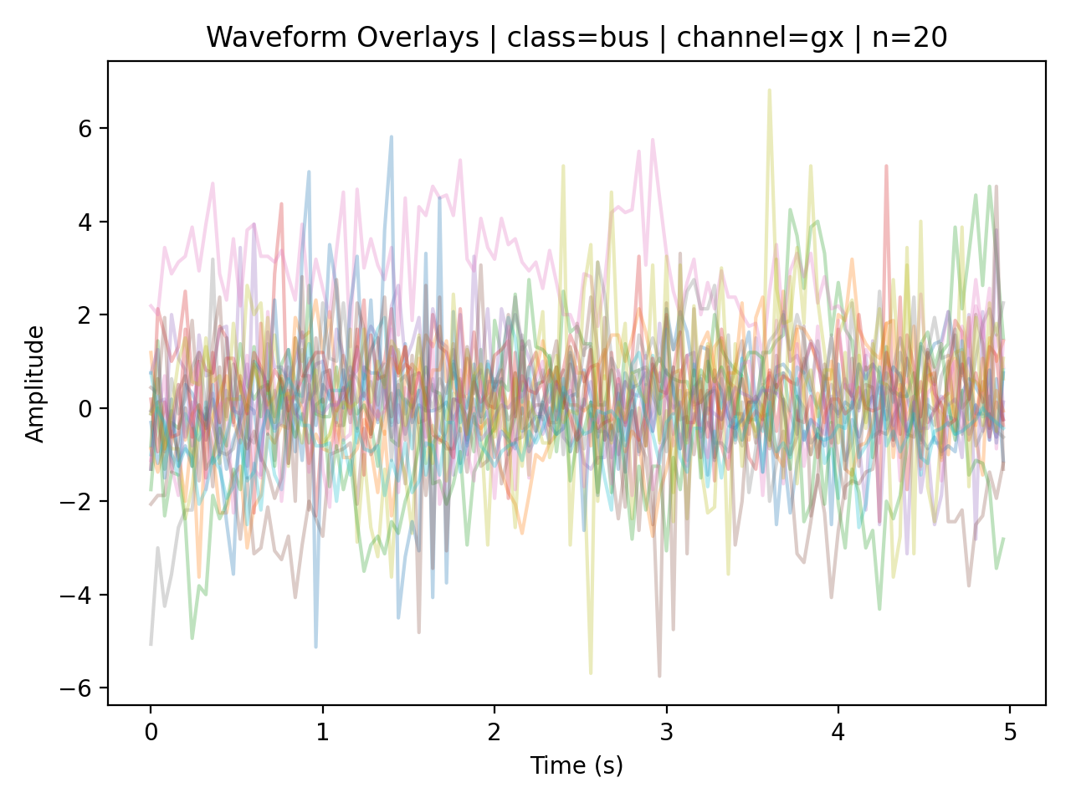
notebooks/plots_waveforms/overlay_bus_gx.png
