spaldrich13/edge-co2-beacon/notebooks/plots_waveforms/overlay_bus_pressure_hpa.png

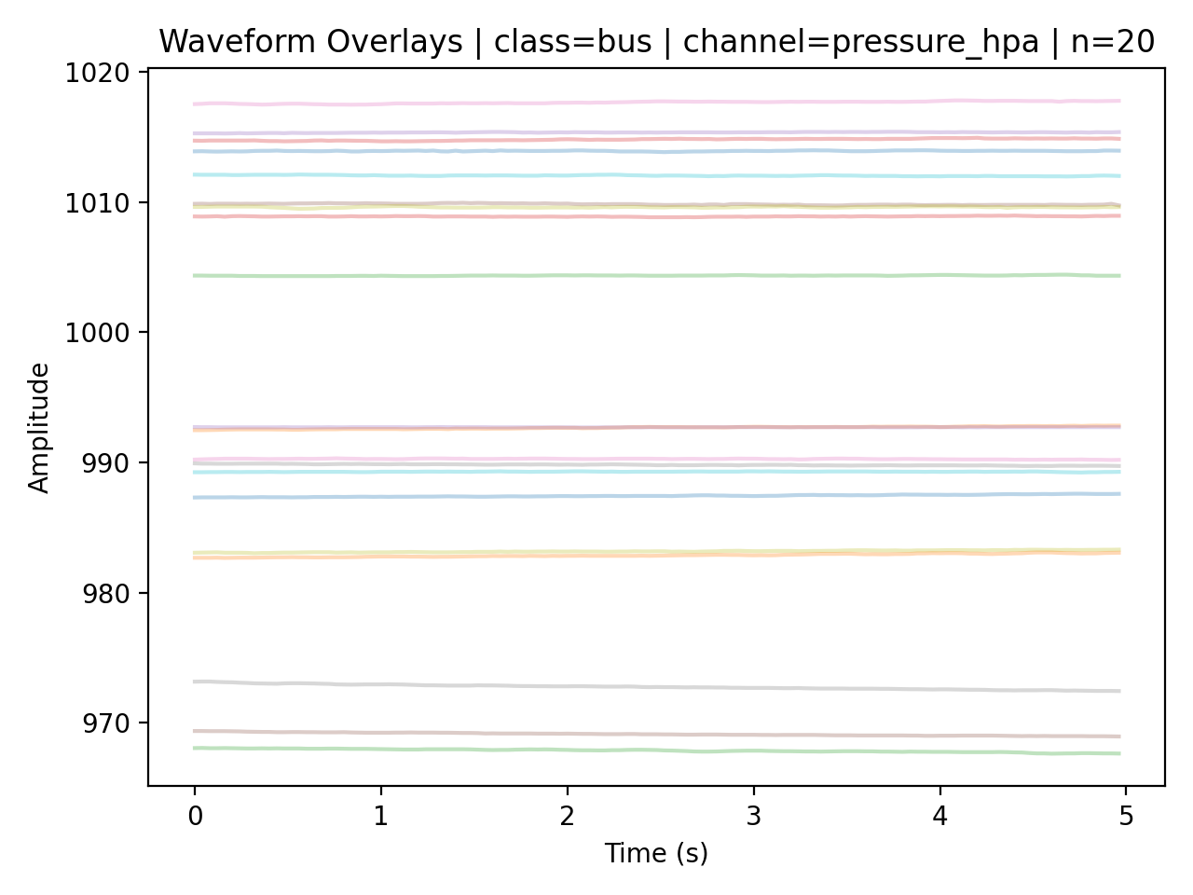
notebooks/plots_waveforms/overlay_bus_pressure_hpa.png
