spaldrich13/edge-co2-beacon/notebooks/plots_waveforms/overlay_car_gy.png

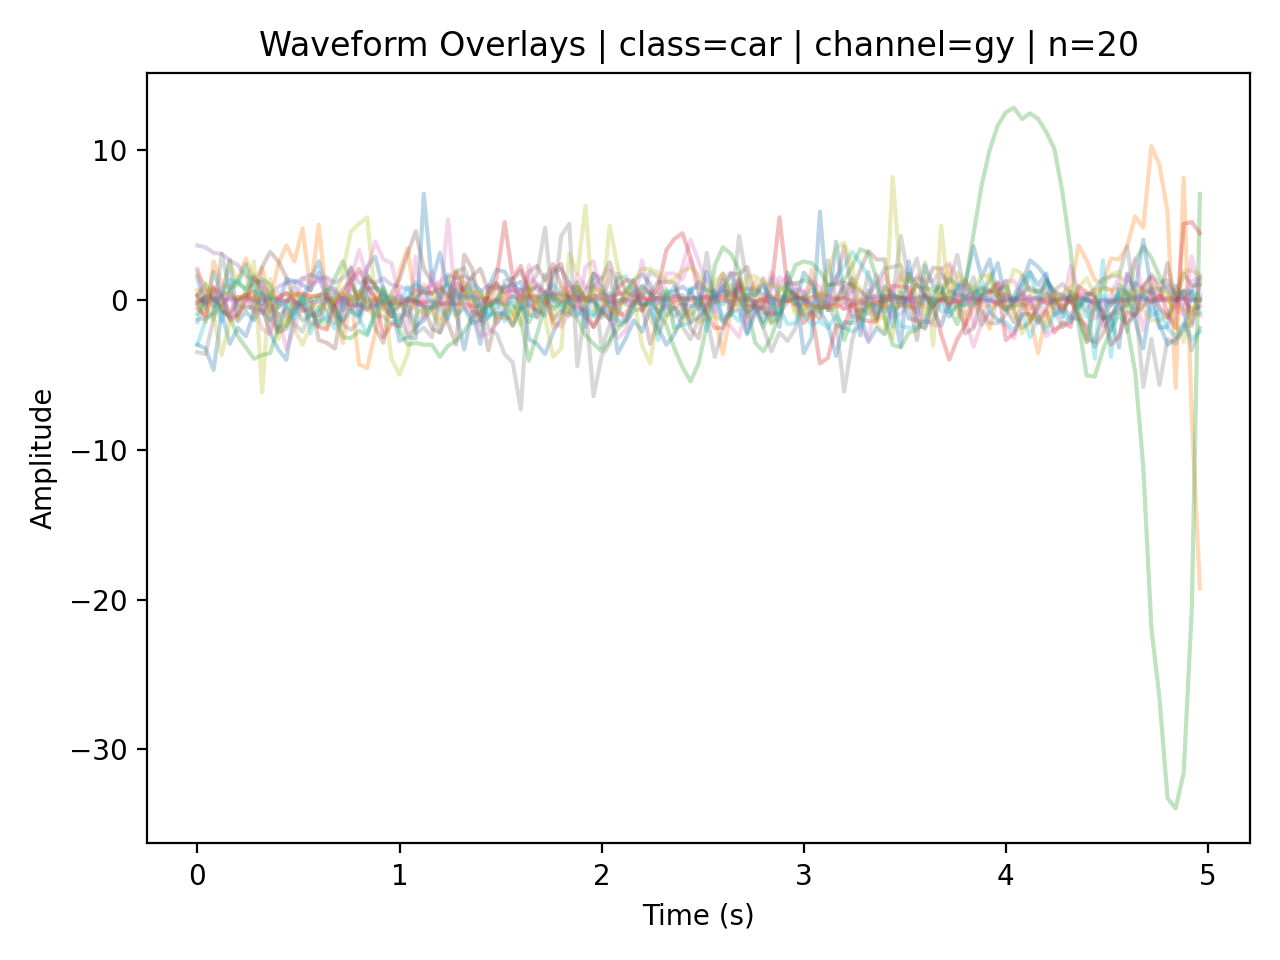
notebooks/plots_waveforms/overlay_car_gy.png
