spaldrich13/edge-co2-beacon/notebooks/plots_waveforms/overlay_subway_ay_corr.png

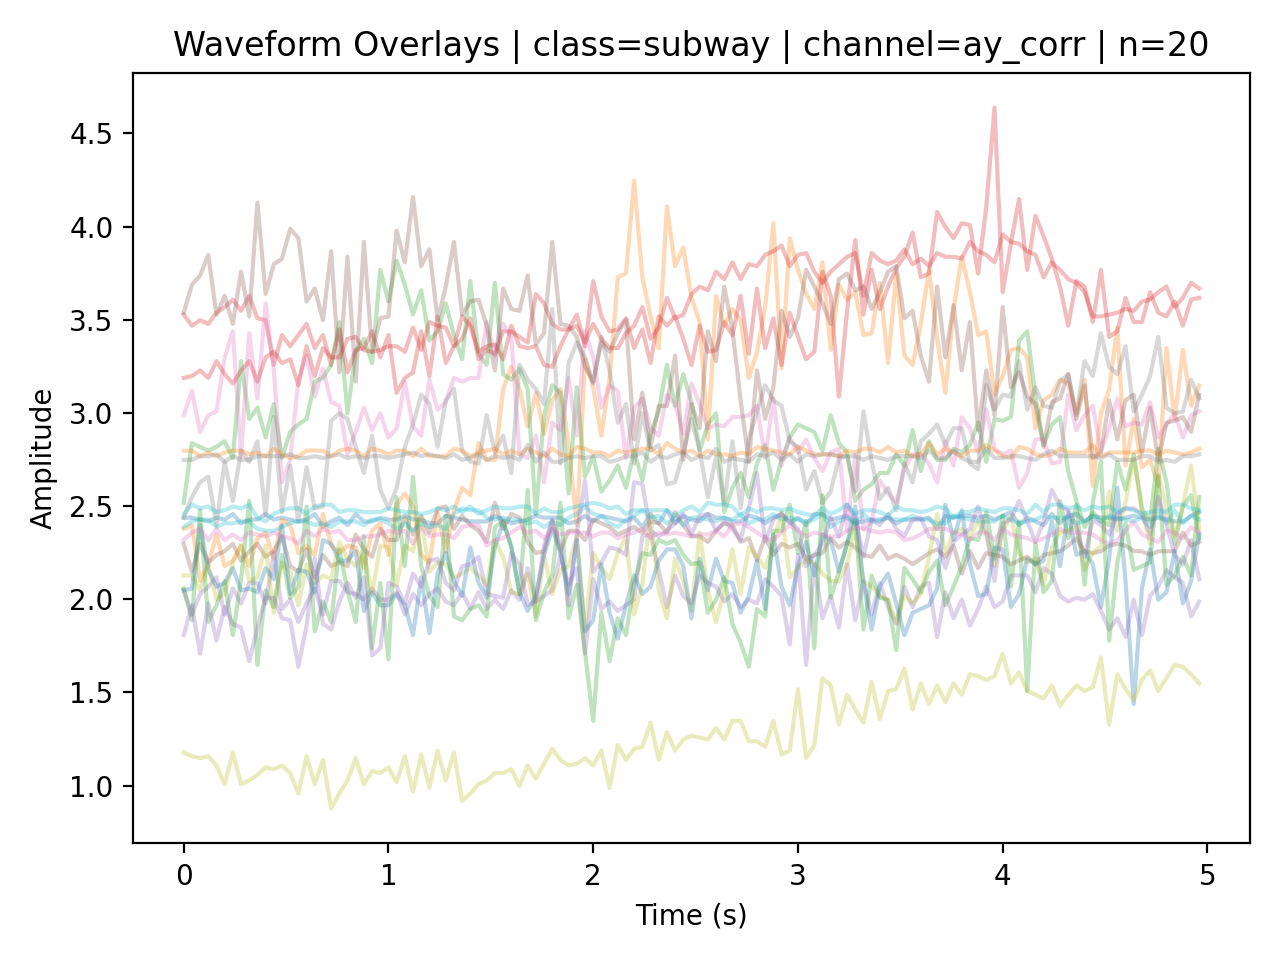
notebooks/plots_waveforms/overlay_subway_ay_corr.png
