spaldrich13/edge-co2-beacon/notebooks/plots_waveforms/overlay_subway_gx.png

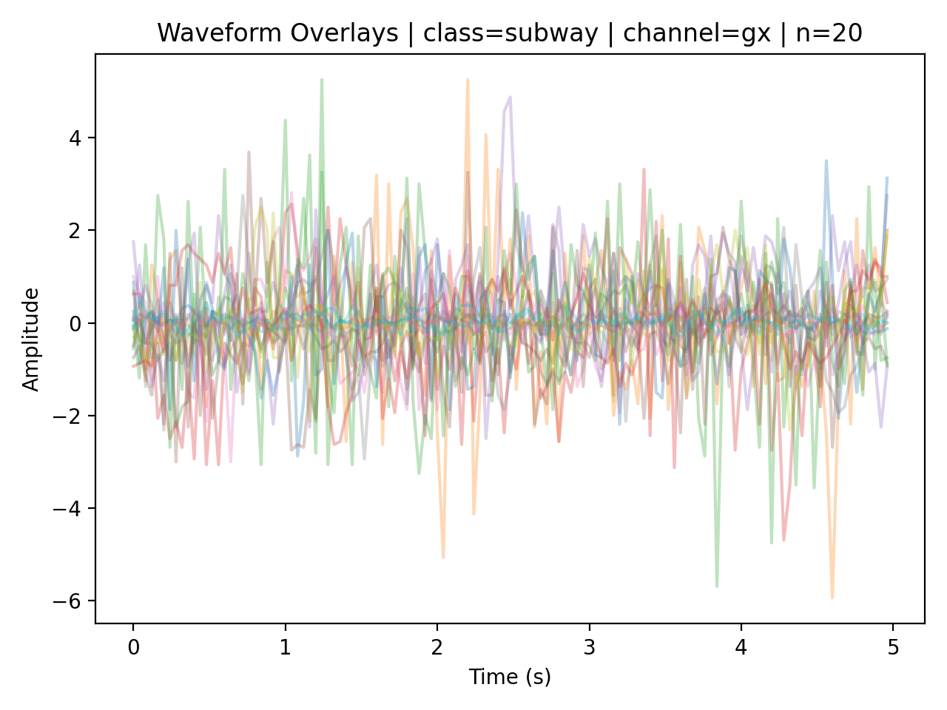
notebooks/plots_waveforms/overlay_subway_gx.png
