spaldrich13/edge-co2-beacon/notebooks/plots_waveforms/overlay_subway_gz.png

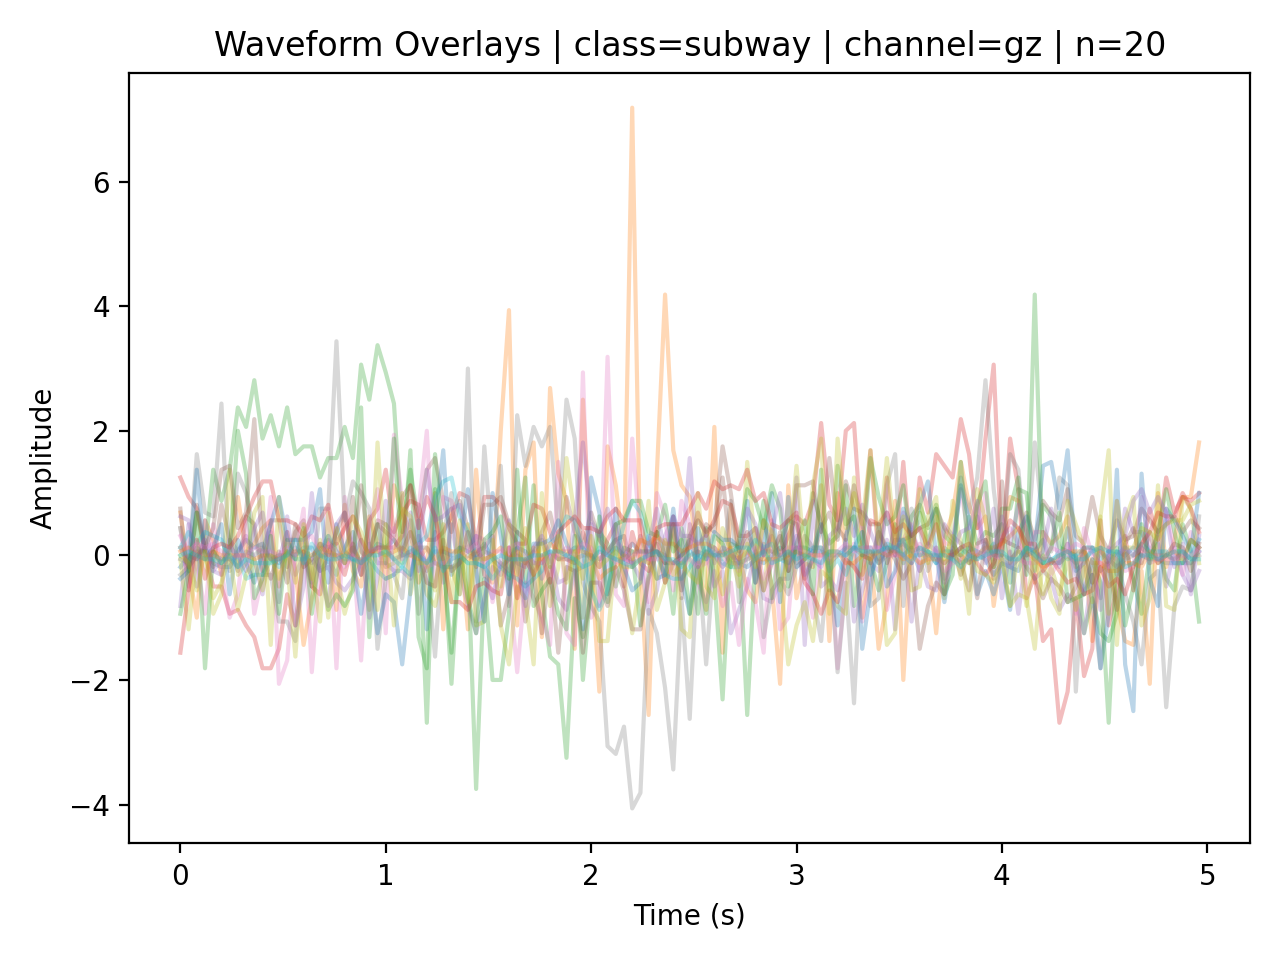
notebooks/plots_waveforms/overlay_subway_gz.png
