spaldrich13/edge-co2-beacon/notebooks/plots_waveforms/overlay_train_gz.png

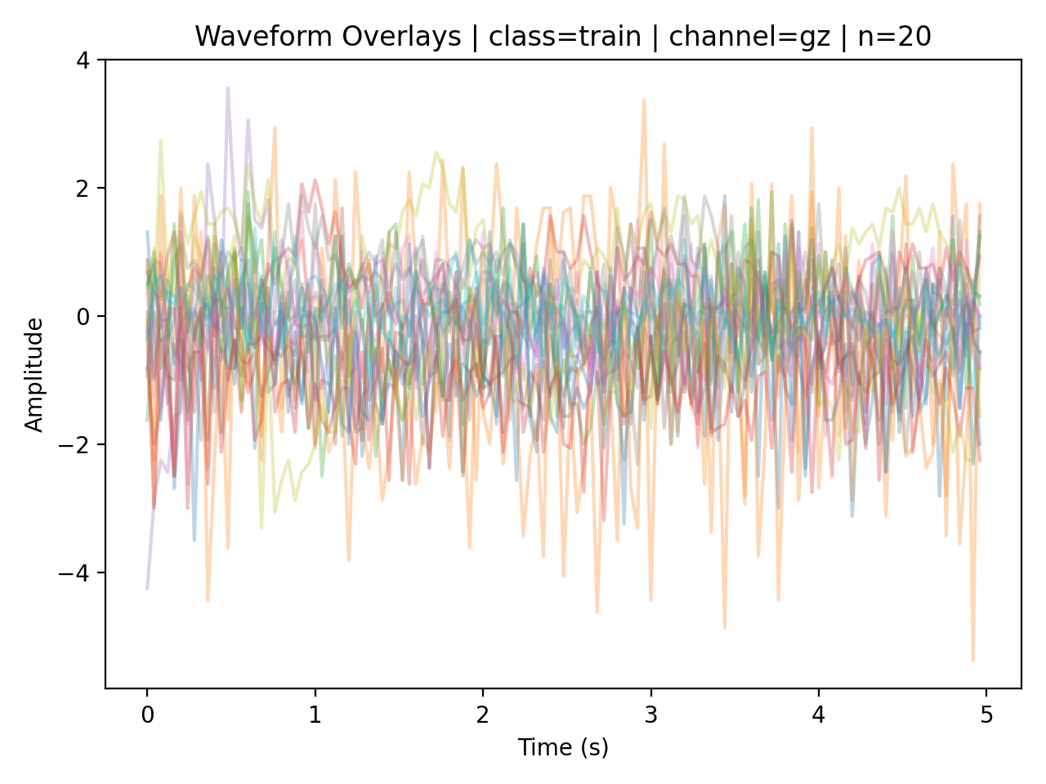
notebooks/plots_waveforms/overlay_train_gz.png
