spaldrich13/edge-co2-beacon/notebooks/plots_waveforms/overlay_walk_az_corr.png

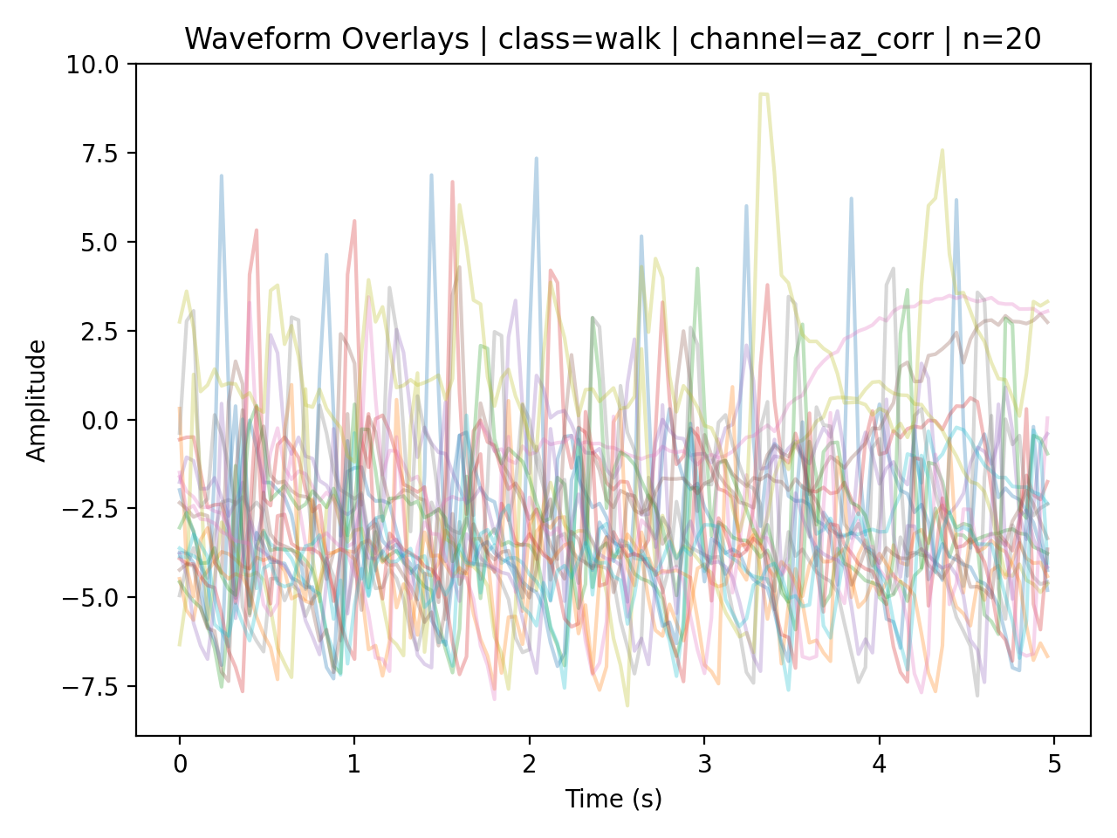
notebooks/plots_waveforms/overlay_walk_az_corr.png
