spaldrich13/edge-co2-beacon/notebooks/plots_waveforms/overlay_walk_gx.png

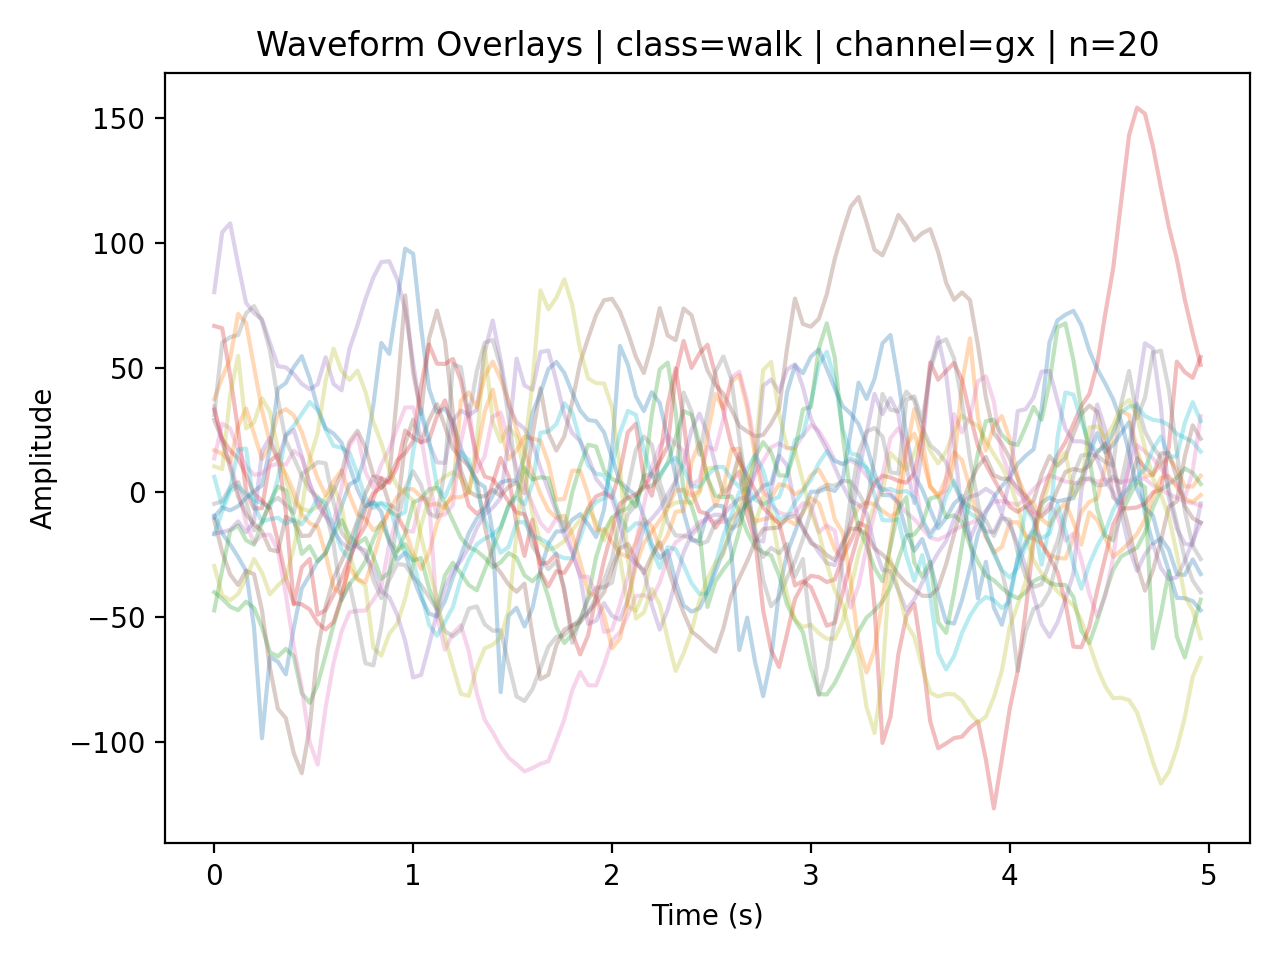
notebooks/plots_waveforms/overlay_walk_gx.png
