spaldrich13/edge-co2-beacon/notebooks/plots_waveforms/overlay_walk_gz.png

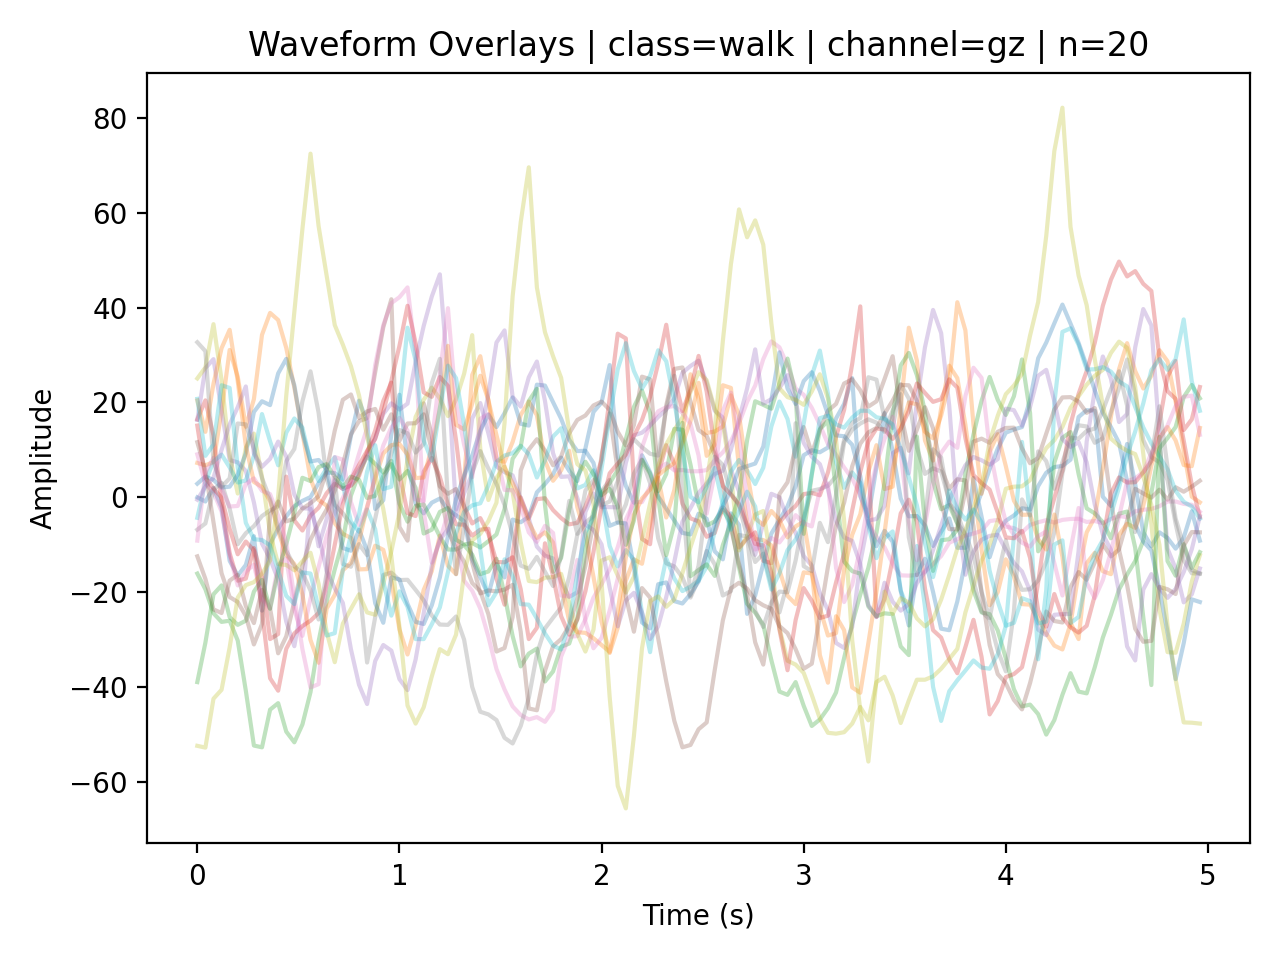
notebooks/plots_waveforms/overlay_walk_gz.png
