spaldrich13/edge-co2-beacon/qa_outputs/qa_summary.csv

file | mode_folder | path | ok | reason | storage_mode_tag | device_mode_tag | mode_mismatch | fs_hz | fs_hz_inferred | segment_id | saved_at | n_rows | t_start_ms | t_end_ms | duration_s | median_dt_ms | fs_est_hz | max_dt_ms | n_gaps_gt_200ms | n_pressure_outliers | n_temp_outliers
bus_seg1_20260204_170911.csv | bus | /Users/spenceraldrich/Desktop/Union/Senior/Winter 2026/ECE-499/data/raw/self_collected/bus/bus_seg1_20260204_170911.csv | True | pressure_outliers | bus | bus | 0 | 25 | 1 | 1 | 2026-02-04T17:09:11.922289 | 31396.0 | 33719.0 | 1289388.0 | 1255.669 | 40.0 | 25.0 | 41.0 | 0.0 | 1.0 | 0.0
bus_seg2_20260204_173011.csv | bus | /Users/spenceraldrich/Desktop/Union/Senior/Winter 2026/ECE-499/data/raw/self_collected/bus/bus_seg2_20260204_173011.csv | True |  | bus | bus | 0 | 25 | 1 | 2 | 2026-02-04T17:30:11.110738 | 29240.0 | 1292869.0 | 2462308.0 | 1169.439 | 40.0 | 25.0 | 41.0 | 0.0 | 0.0 | 0.0
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
