spaldrich13/edge-co2-beacon/(commit log)

2026-02-26 Initial commit — ECE499 edge-co2-beacon capstone
    [bus_seg1_20260204_170911.csv, bus_seg2_20260204_173011.csv, bus_seg3_20260204_175040.csv, car_prelim_20260113_171143.csv, car_prelim_20260113_174603.csv, car_seg1_20260203_192212.csv, car_seg2_20260203_194440.csv, car_seg3_20260224_143641.csv]
2026-02-26 Add .gitignore — exclude large data files and DS_Store
2026-03-02 [#3][#4][#5][#6] Inference firmware — 25Hz sampling, preprocessing, TFLite, latency
2026-03-03 [#1] Dense(32) retrain — reduced model flash footprint
    Model retrained with Dense(32) instead of Dense(64), cutting the
    dominant layer from ~717KB to ~359KB. New INT8 TFLite model: 361KB
    (was 729KB), freeing ~368KB of application flash headroom.
    - model/co2_beacon_int8.tflite: replaced with Dense(32) model (369,576 bytes)
    - firmware/beacon_inference/model_data.h: regenerated via xxd, both
    array and length declared const to keep model in flash (.rodata)
    - firmware/beacon_inference/beacon_inference.ino: fixed arena comment (50KB)
    - notebooks/retrain_dense32.md: documents the change and flash budget math
2026-03-03 [#3][#4][#5][#6] Firmware running on hardware — latency 259ms PASS
    First hardware validation on Adafruit Feather nRF52840:
    - 25Hz sampling: confirmed (Issues #3, #4)
    - TFLite inference: running, output MODE:subway CONF:69% LAT:259ms (Issue #5)
    - Latency: 259ms vs ≤1000ms spec — PASS (Issue #6)
    - Flash: 62% used, RAM: 28% used
    - BNO055 + BMP390 both initialized successfully at 0x28 / 0x77
    Updated docs/CLAUDE.md: marked #1–#6 complete, added Hardware
    Validation Results table, corrected Dense(64)→Dense(32) architecture.
2026-03-03 [#10][#11] Distance and CO₂ estimation — Serial output only
    Issue #10 — Distance estimation:
    delta_m = SPEED_MPS[mode_id] × 4.0s per inference step
    Speed table (m/s): train=16.7, subway=13.9, car=11.1, bus=8.3, walk=1.4
    Issue #11 — CO₂ estimation:
    co2_g += delta_m × CO2_KG_PER_KM[mode_id]
    Factors (kg/km): train=0.035, subway=0.041, car/bus=0.089, walk=0.000
    Trip boundary resets accumulators and prints TRIP_END summary:
    Condition A: motorised → walk transition
    Condition B: walk sustained ≥ 60 s at confidence ≥ 80%
    Serial output now: MODE:car CONF:87% LAT:259ms DIST:44.4m CO2:3.9g
    No BLE — Serial only. Accumulators ready to wire into BLE TripRecord (Issu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
2026-03-03 [#8] BLE GATT service — LiveStatus + TripRecord characteristics
    Service UUID: 4fafc201-1fb5-459e-8fcc-c5c9c3319100
    LiveStatus UUID: 4fafc201-1fb5-459e-8fcc-c5c9c3319101 (Notify, 7 B, 1 Hz)
    TripRecord UUID: 4fafc201-1fb5-459e-8fcc-c5c9c3319102 (Read+Notify, 20 B)
    LiveStatus payload (7 bytes):
    [0] mode_id [1] confidence [2-5] timestamp_s LE [6] trip_active
    TripRecord payload (20 bytes, sent on every TRIP_END):
    [0-1] trip_id [2] mode_id [3] confidence
    [4-7] ts_start [8-11] ts_end [12-13] duration_s
    [14-15] distance_m [16-17] co2_g [18-19] reserved
    Implementation details:
    - Bluefruit52Lib (nRF52 core), NOT ArduinoBLE
    - Advertising name "CO2-Beacon", fast ~100ms / slow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
2026-03-07 [#6] Formal latency measurement: 261.6ms mean, σ=0.7ms, n=30 (spec ≤1000ms PASS)
2026-09-18 Add README, figures, poster; dashboard update; battery check sketch
